asosab/bot_sigue_linea/web/assets/img/bola_trasera_construccion.jpg

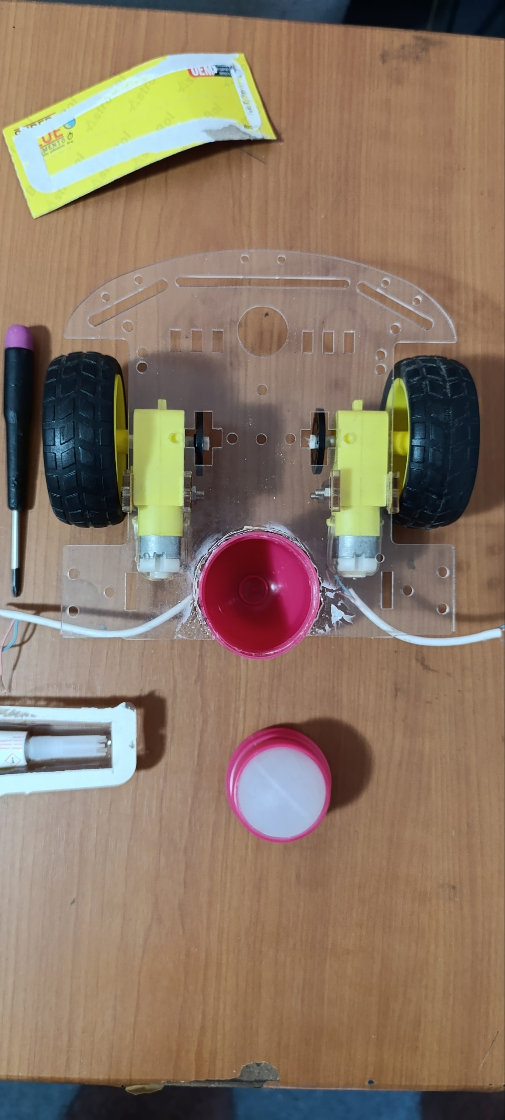
web/assets/img/bola_trasera_construccion.jpg
