asosab/bot_sigue_linea/web/assets/img/linea_de_prueba.jpg

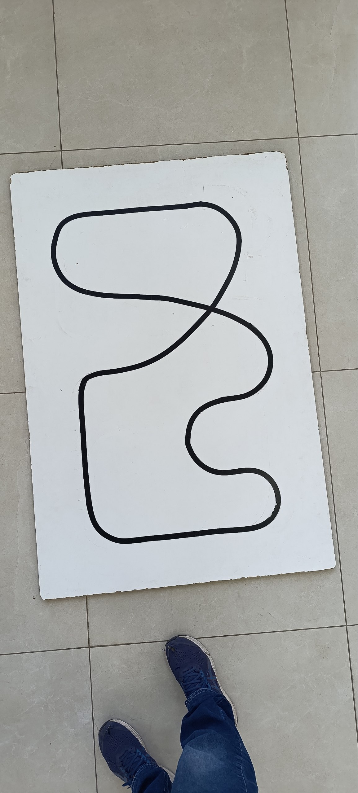
web/assets/img/linea_de_prueba.jpg
