asosab/bot_sigue_linea/web/assets/pdf/anexo-G-reconocimiento_concurso_robotica.pdf

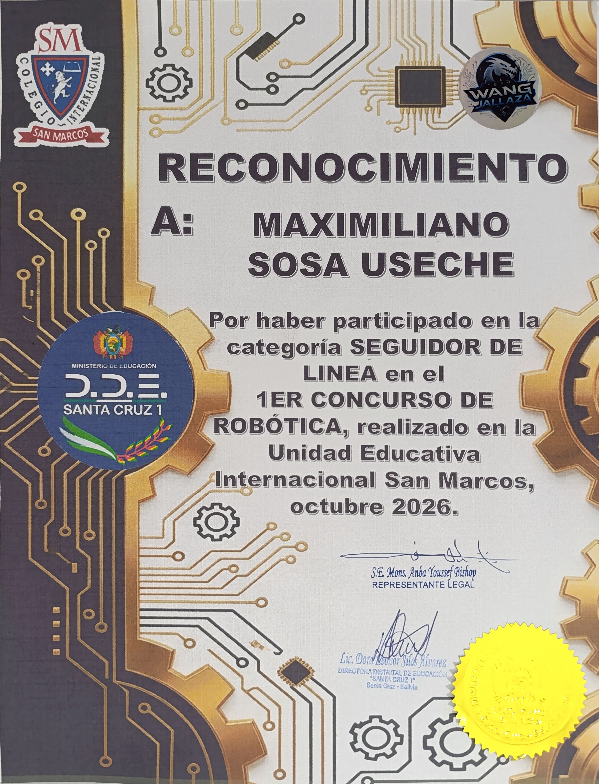
[picture p4: page 1]
