asosab/bot_sigue_linea/web/assets/img/afinando-sensores.jpg

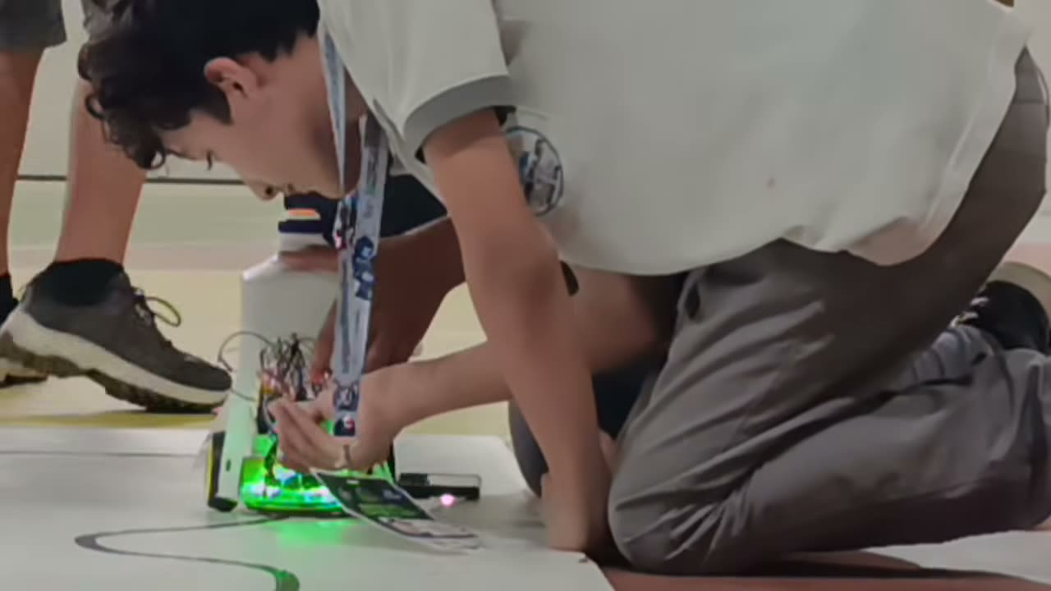
web/assets/img/afinando-sensores.jpg
