asosab/bot_sigue_linea/web/assets/img/anexo-D1-captura-borrado-y-expulsion.jpg

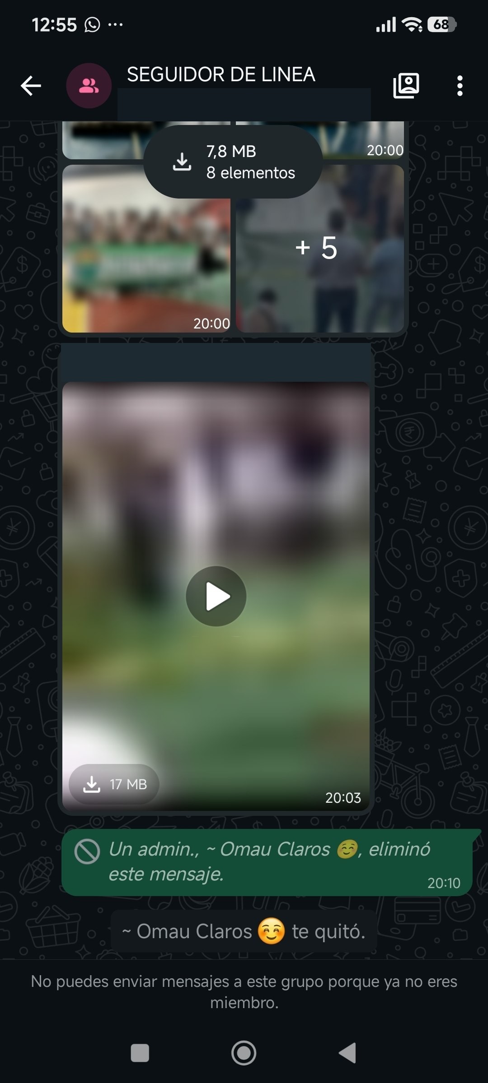
web/assets/img/anexo-D1-captura-borrado-y-expulsion.jpg
