asosab/bot_sigue_linea/web/assets/img/anexo-D2-captura-expulsiones-tercero.jpg

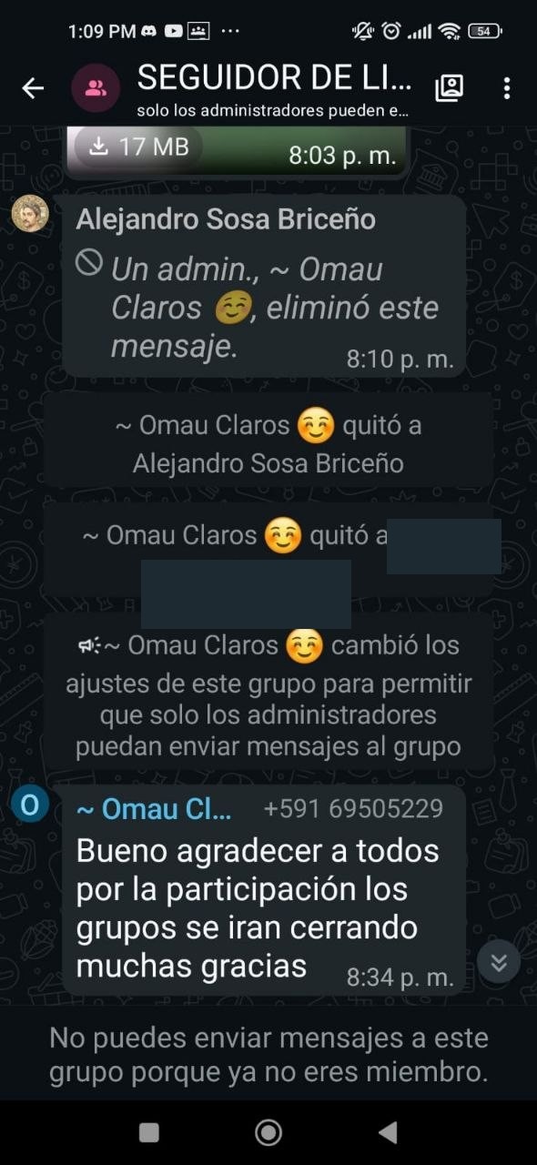
web/assets/img/anexo-D2-captura-expulsiones-tercero.jpg
