asosab/bot_sigue_linea/web/assets/img/anexo-F1-captura-publicacion-distrito.png

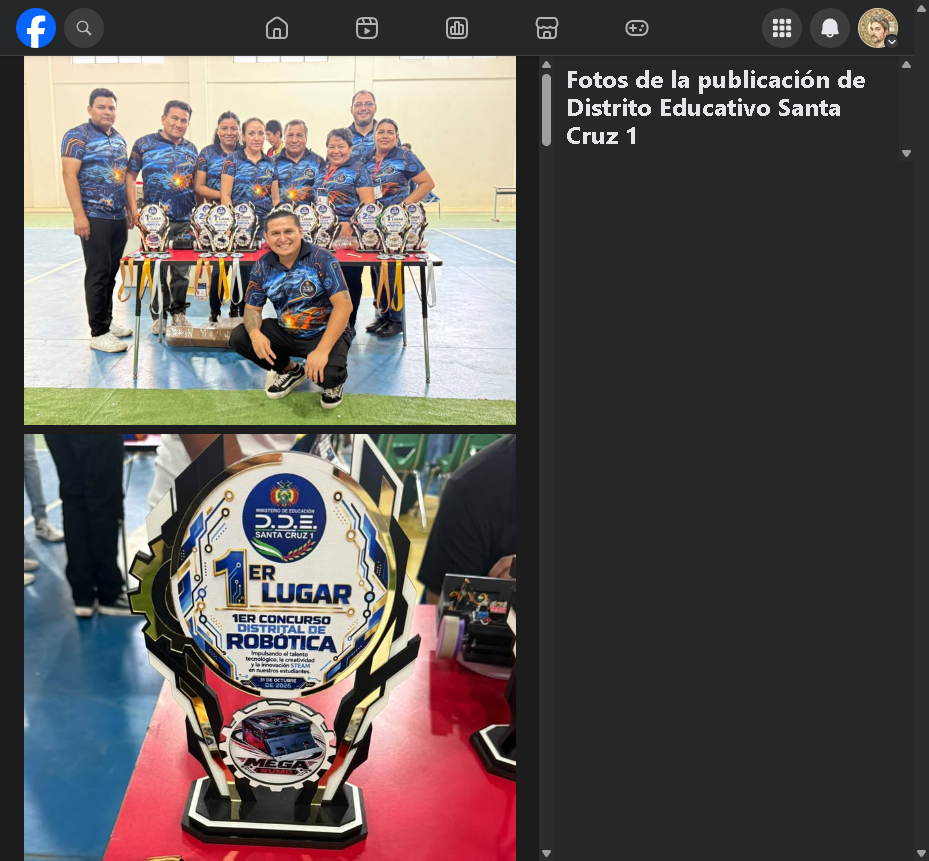
web/assets/img/anexo-F1-captura-publicacion-distrito.png
