asosab/bot_sigue_linea/web/assets/img/bola_trasera.jpg

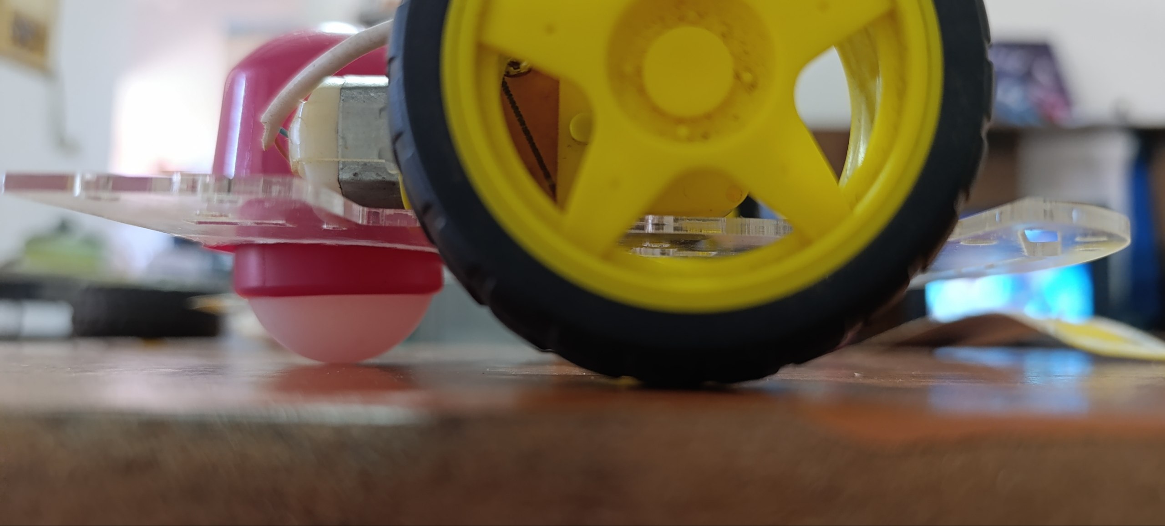
web/assets/img/bola_trasera.jpg
