asosab/bot_sigue_linea/web/assets/img/bot_cableando.jpg

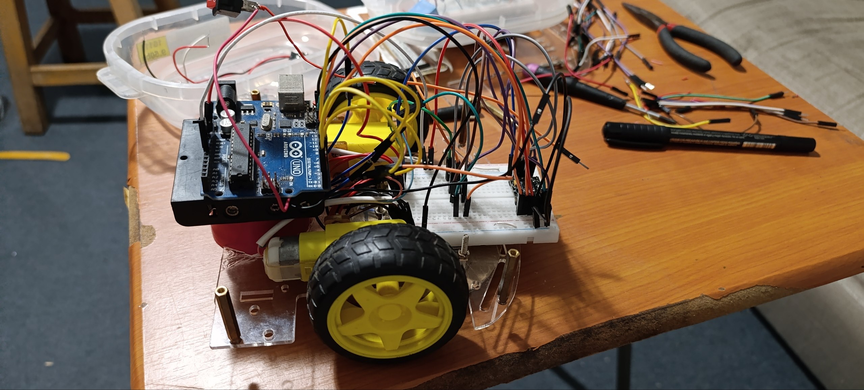
web/assets/img/bot_cableando.jpg
