asosab/bot_sigue_linea/web/assets/img/Christopher_Darius_Valero_Lima.jpg

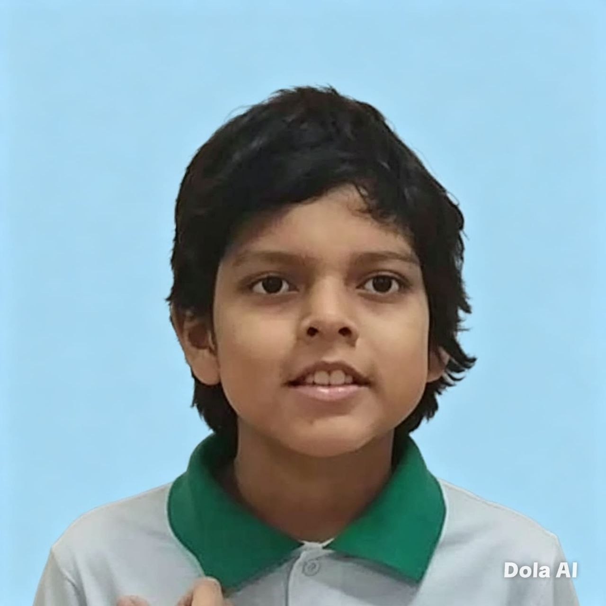
web/assets/img/Christopher_Darius_Valero_Lima.jpg
