asosab/bot_sigue_linea/web/assets/img/compartir.png

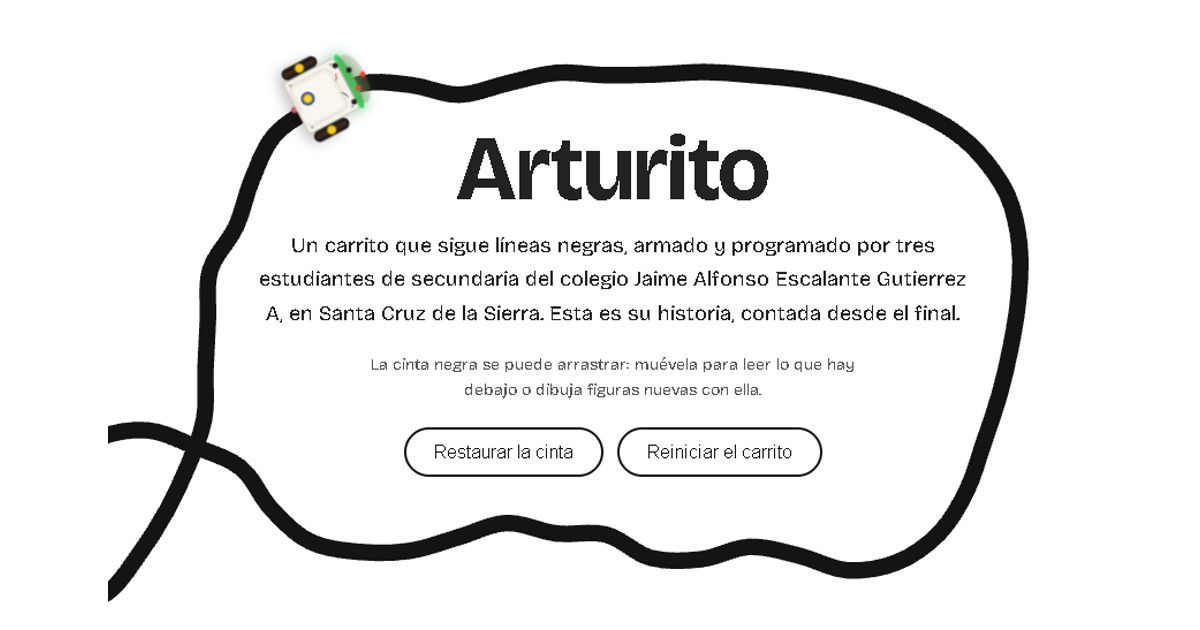
web/assets/img/compartir.png
