asosab/bot_sigue_linea/web/assets/img/formacion_sensores_luz.jpg

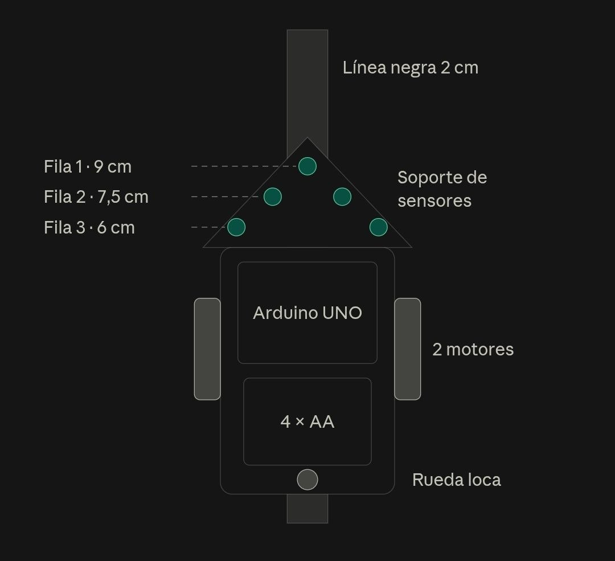
web/assets/img/formacion_sensores_luz.jpg
