asosab/bot_sigue_linea/web/assets/img/Gaby_Leryn_Ayala_Chambi.jpg

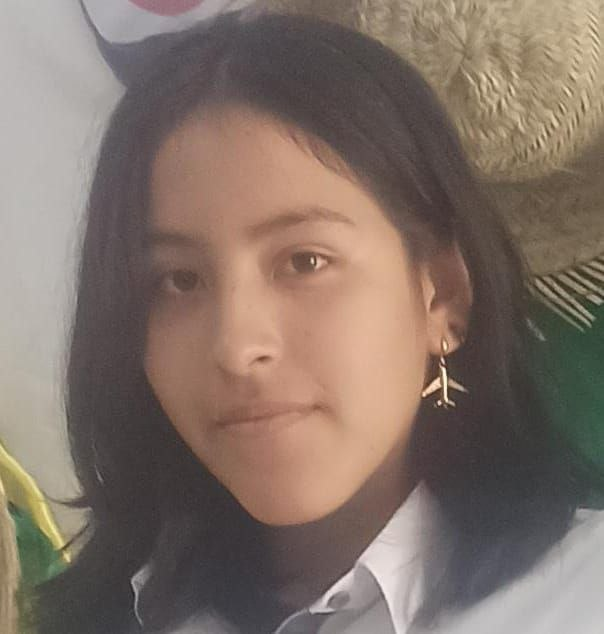
web/assets/img/Gaby_Leryn_Ayala_Chambi.jpg
