asosab/bot_sigue_linea/web/assets/img/gaby_y_max_concurso.jpg

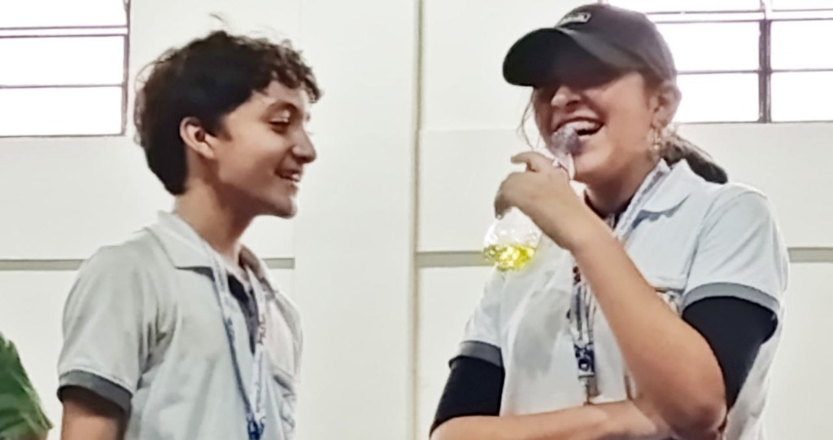
web/assets/img/gaby_y_max_concurso.jpg
