asosab/bot_sigue_linea/web/assets/img/Maximiliano_Sosa_Useche.jpg

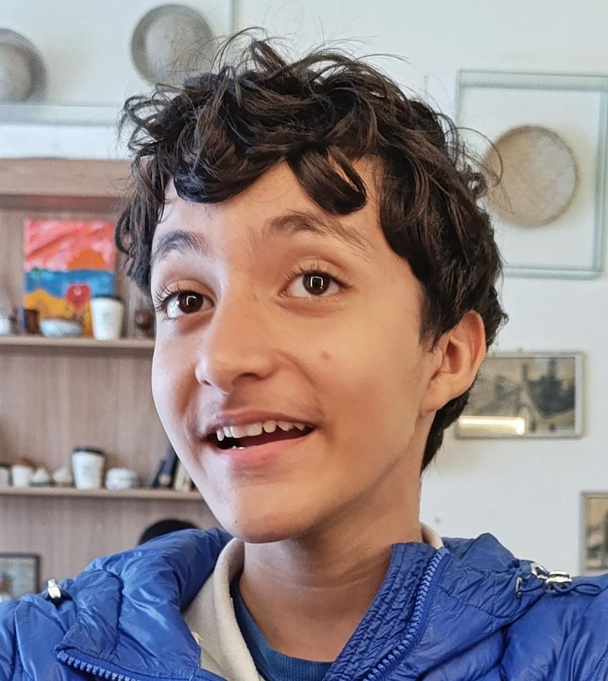
web/assets/img/Maximiliano_Sosa_Useche.jpg
