asosab/bot_sigue_linea/web/assets/img/sensores.jpg

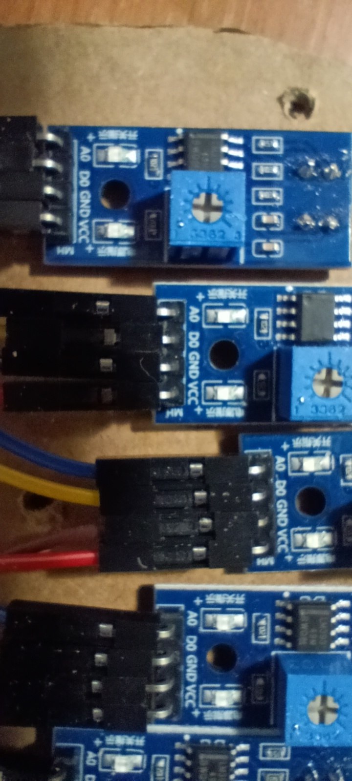
web/assets/img/sensores.jpg
