asosab/bot_sigue_linea/web/assets/img/sensores_instalados.jpg

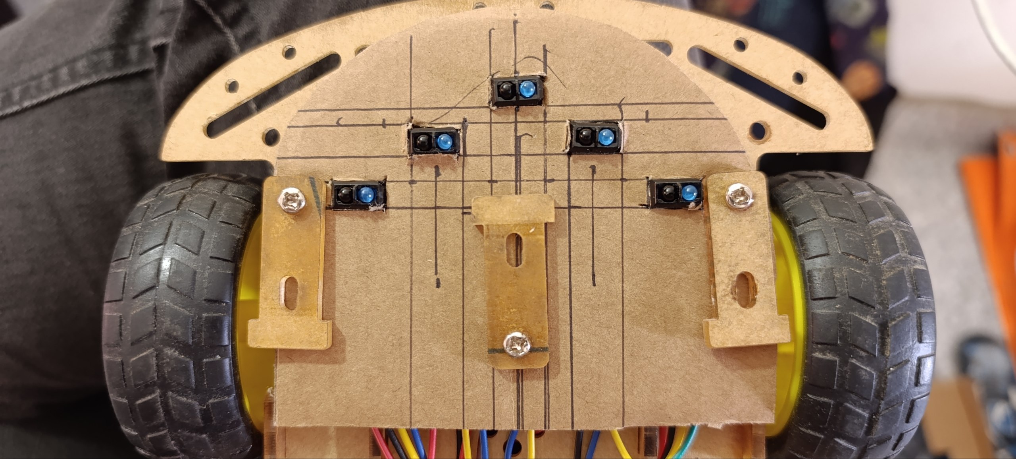
web/assets/img/sensores_instalados.jpg
