asosab/bot_sigue_linea/web/assets/img/yt-arturito-vuelta.jpg

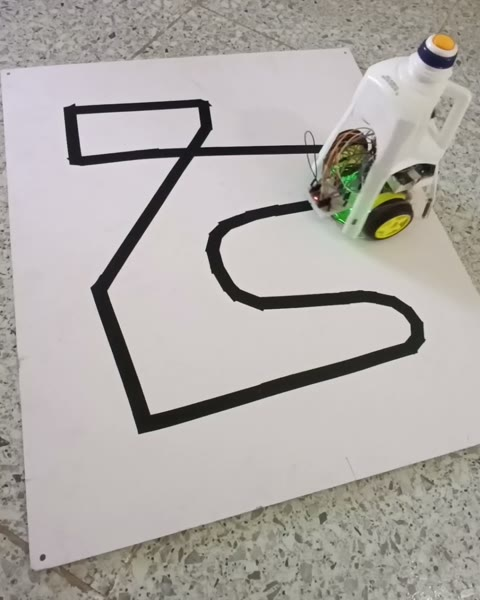
web/assets/img/yt-arturito-vuelta.jpg
