asosab/bot_sigue_linea/web/assets/img/yt-san-marcos-1.jpg

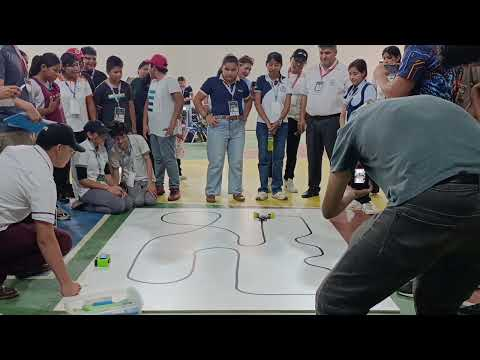
web/assets/img/yt-san-marcos-1.jpg
