asosab/bot_sigue_linea/web/assets/img/yt-san-marcos-2.jpg

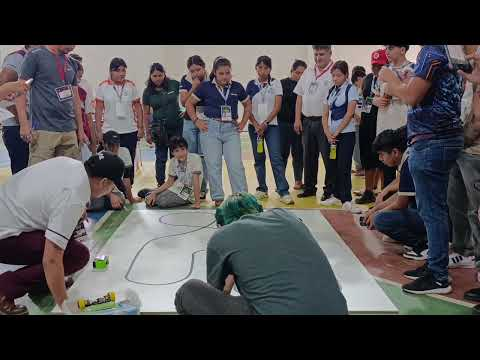
web/assets/img/yt-san-marcos-2.jpg
