asosab/bot_sigue_linea/web/assets/img/bot_linea_prueba.jpg

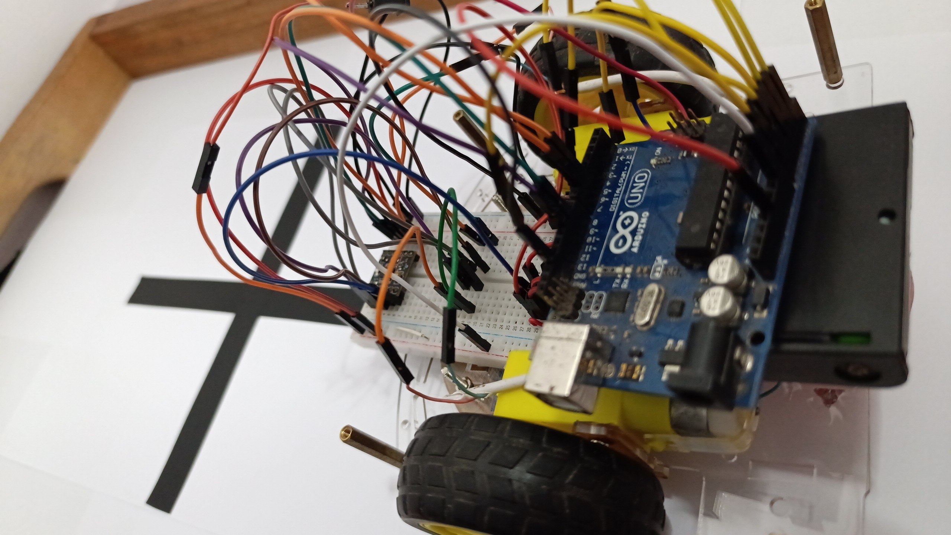
web/assets/img/bot_linea_prueba.jpg
