asosab/bot_sigue_linea/firmware/arturito_cv2_12/arturito_cv2_12.ino

/*
 * ==========================================================
 * ROBOT: ARTURITO CV2.12 - COMPETENCIA (v2.12 sin EEPROM)
 * CONCURSO: 1er Concurso Distrital de Robotica 2026 (Santa Cruz)
 * ==========================================================
 * Base: v2.11, intacta (la ultima verificada: 19.3 s, circuito
 * completo). La v2.12 agrega un solo cambio reversible:
 *
 *   v2.12  Recuperacion = la de v2.11, intacta. Se probaron dos
 *          fases (350 ms ultimoLado + 700 ms contrario) y acotar
 *          el pivoteo a 500 ms: el lazo seguia fallando, el
 *          problema no es COMO busca sino QUE no sabe hacia donde
 *          se fue la linea.
 *
 *          Diagnostico nuevo: cada evento 'P' guarda una mascara
 *          de los sensores que aun veian linea (negrura > 0.15)
 *          en el primer ciclo de la perdida. En la esquina del
 *          lazo dice si la linea se escapa por S3/S4 (el bot ya
 *          paso el vertice: problema de llegada) o por S0/S1.
 *          Se lee en el informe como "vista: Sx Sy".
 *
 *          Rebobinado recto: el diferencial viejo giraba la nariz
 *          al lado contrario del que se fue la linea (la rueda de
 *          ese lado retrocedia mas rapido) — origen real de los
 *          regresos de 180 grados. Ahora retrocede en linea con
 *          el rumbo congelado: lo que reenganche queda de frente.
 *
 *          Reenganche honesto en la busqueda: un roce en una punta
 *          ya no cuenta como linea encontrada — exige el trio
 *          S1/S2/S3 sobre la linea (TRIO_ENGANCHE). En la 2a
 *          esquina del lazo el pivoteo mordia la linea de entrada
 *          en angulo malo y salia para atras. Ademas el pivoteo
 *          se acota a 450 ms (~120-150 grados): si en el cono
 *          delantero no hay enganche solido, rebobina con el
 *          rumbo original.
 *
 *          Lado de busqueda por posF con umbral 0.2 (era 0.5): la
 *          mascara 'vista' mostro la linea escapando por S0 y el
 *          bot pivotando a la derecha — posF filtrado no llegaba
 *          a -0.5 antes de perderla y ultimoLado quedaba con un
 *          valor viejo. Con 0.2 una salida rapida ya marca lado.
 *
 *          Calibracion viva de largada: mientras espera el boton,
 *          el apoyo siembra la pista en cada ciclo — S0/S4 siempre
 *          ven blanco y S2 siempre negro, ese rango real
 *          reemplaza a la calibracion de laboratorio (idea
 *          rescatada del enfoque de v2.5/v2.6: cada comienzo
 *          define su propio blanco/negro). La compuerta pasa a
 *          medir margen en ADC crudo, no negrura normalizada.
 *
 *          Boost de recta: si |posF| < RECTA_POS se sostiene
 *          RECTA_CICLOS seguidos (~140 ms de linea centrada, no
 *          un instante entre curvas), VEL_MAX suma BOOST_RECTA
 *          (180 -> 205). Al moverse posF, vuelve a 180: las
 *          esquinas se siguen tomando a la velocidad conocida.
 *          Primera corrida (40 ciclos, pos 0.3): 20.2 s — el
 *          boost probablemente nunca se armo; ahora se afloja el
 *          requisito y cada activacion queda como evento 'B' en
 *          el informe, para ver si dispara y donde.
 *
 * Descartado en el camino (experimentos que rompieron la esquina
 * de 90 del lazo; no van):
 *   - Cruce por suma (SUMA_CRUCE): un vertice de esquina tambien
 *     pone varios sensores sobre linea a la vez; el avance recto
 *     comprometido se la pasaba de largo. La suma no distingue
 *     cruce de esquina.
 *   - LADO_MIN en la gracia y GIRO_BUSQUEDA_MS 500: parches al
 *     error que el cruce por suma introducia. Con la base de
 *     v2.11 la esquina se resolvia sola.
 *
 * Cambios heredados de v2.11:
 *
 *   v2.11  PERDIDA_CICLOS 1 -> 10 (gracia antes de recuperar: la
 *          corrida anterior registro 86 "perdidas" en 21.5 s, una
 *          cada ~0.25 s; son parpadeos de la suma de negrura bajo
 *          el umbral 0.3, no salidas de linea. Cada uno disparaba
 *          el pivoteo de busqueda y frenaba el avance. Ahora hay
 *          que perder ~60-70 ms seguidos para entrar a recuperar;
 *          durante la gracia sigue el PD con la ultima posF).
 * Cambios heredados de v2.1:
 *
 *   Ronda 1  KD 25 -> 80          (derivada con efecto real)
 *            TRIM_DER 1.0 -> 1.02 (compensa deriva a la derecha)
 *   Ronda 2  AVANCE_CRUCE_MS 200 -> 140 (menos avance ciego)
 *   Ronda 3  K_PUNTA 1.0 -> 0.5   (S0/S4 tiran menos cuando
 *                                  S1/S2/S3 ya ven la linea)
 *   Extra    Registro en EEPROM (sin cable en pista): tiempo,
 *            perdidas, cruces, linea de tiempo de eventos y
 *            calibracion final. Se lee despues por Serial:
 *            'r' muestra el informe, 'b' lo borra.
 *
 * Para volver a v2: KD=25, TRIM_DER=1.0, AVANCE_CRUCE_MS=200,
 * K_PUNTA=1.0, PERDIDA_CICLOS=1, BOOST_RECTA=0,
 * GIRO_BUSQUEDA_MS=1500, TRIO_ENGANCHE=0, SUMA_AMBIGUA=99.
 *
 * Arranque de competencia: se enciende en la mano, con motores
 * parados, se apoya sobre la linea. Apretar el pulsador de
 * largada (D8) prepara el arranque y soltarlo larga el robot,
 * siempre que S2 siga sobre negro y los extremos S0/S4 libres:
 * si esta mal apoyado no arranca y da tiempo de reacomodarlo.
 * Mantenerlo apretado mientras se baja el robot tambien sirve:
 * larga al soltar. En carrera, apretar detiene y devuelve a la
 * espera; un ciclo apretar-soltar nuevo lo relanza con la misma
 * regla. Sin prueba de motores ni ventana de calibracion: el
 * reglamento no permite tocarlo una vez en carrera. Antes de
 * pulsar se puede verificar el LED del modulo S2 encendido
 * = esta viendo la linea.
 *
 * - Posicion continua (media ponderada de los 5 canales
 *   analogicos) filtrada con EMA: corta el bamboleo.
 * - Velocidad adaptativa: a fondo en rectas, baja en curvas.
 * - Calibracion adaptativa: parte de valores de laboratorio y
 *   se ajusta sola en marcha; al apoyarlo, la posicion de
 *   salida siembra el blanco y el negro reales de la pista.
 * - Interseccion: al ver todo negro avanza recto un tramo
 *   fijo sin leer, para no tomar un ramal por una lectura a
 *   medio cruce.
 * - Recuperacion: gira hacia el ultimo lado que vio la linea
 *   y, si no la encuentra, rebobina (retrocede buscando).
 * - Trim de motores: TRIM_IZQ/TRIM_DER corrigen la deriva en
 *   recta (medir en el piso y ajustar a mano).
 *
 * Hardware: UNO + 5xTCRT5000 (A0..A4, flecha: S2 adelante,
 * S1/S3 medios, S0/S4 atras en las puntas) + DRV8833 (IN1..IN4
 * en D5/D6/D9/D10, EEP en D4, ULT en D2).
 */


// --- PINES ---
#define S0 A0 // extremo izquierdo (atras en la flecha)
#define S1 A1 // medio izquierdo
#define S2 A2 // centro (punta adelantada)
#define S3 A3 // medio derecho
#define S4 A4 // extremo derecho (atras en la flecha)

#define IN1 5   // motor izquierdo adelante (PWM)
#define IN2 6   // motor izquierdo atras (PWM)
#define IN3 9   // motor derecho adelante (PWM)
#define IN4 10  // motor derecho atras (PWM)
#define SLEEP_DRV 4 // EEP del DRV8833: HIGH = despierto
#define FAULT_PIN 2 // ULT del DRV8833 (opcional)
#define BTN 8       // pulsador de largada: entre D8 y GND, pull-up
                    // interno (presionado = LOW). Sin resistencias.

// --- PARAMETROS DE CONTROL ---
const int VEL_MAX = 180;   // velocidad en recta (190 perdio el camino)
const int VEL_MIN = 70;    // velocidad en curva cerrada
const float KP = 40.0;     // giro proporcional por unidad de posicion
const float KD = 80.0;     // amortigua el zigzag (v2: 25). Se mide por
                           // ciclo de loop: no cambiar delay(5) —
                           // delay(2) rompio el lazo (posF ruidosa)
const float KS = 70.0;     // cuanto baja la velocidad con el error
const float KS2 = 150.0;   // freno por derivada: posF moviendose rapido
                           // = curva empezando; baja antes de salirse
const float ALPHA = 0.4;   // filtro EMA de la posicion (0..1)
                           // (0.5 dejo posF nervioso: mas perdidas)
const int REV_MAX = 60;    // reversa maxima corrigiendo (anti-pivoteo)

// Trim de motores (1.0 = igual). Si tira a la derecha, bajar TRIM_IZQ
// o subir TRIM_DER. Se ajusta a mano tras la prueba de recta.
const float TRIM_IZQ = 1.0;
const float TRIM_DER = 1.02; // v2: 1.0

// Compuerta de arranque: margen en ADC crudo contra el blanco que
// ven S0/S4 en ese instante. Contrastes reales de pista ~800.
const int MARGEN_PISTA = 300;   // S2 tiene que superar al blanco en esto
                               // las puntas no pueden pasar de la mitad

// Puntas S0/S4: peso relativo cuando el trio S1/S2/S3 ya ve linea.
// 1.0 = como v2; 0.5 = mitad del tiron; 0.0 = puntas excluidas.
const float K_PUNTA = 0.5;
const float UMBRAL_TRIO = 0.3;

// Interseccion: avance recto comprometido al ver todo negro
const int VEL_CRUCE = 140;
const unsigned long AVANCE_CRUCE_MS = 140; // v2: 200

// Geometria ambigua: con esta suma hay mas de una linea bajo el
// arreglo (cruce o vertice de esquina); el centroide miente y
// posF se congela en lo que traia. 99 = desactivado.
const float SUMA_AMBIGUA = 2.0;

// Antirrebote del pulsador (flanco estable despues de este tiempo)
const unsigned long BTN_DEBOUNCE_MS = 50;

// Recuperacion de linea perdida
const unsigned long GIRO_BUSQUEDA_MS = 450; // arco de pivoteo antes de
                                            // rebobinar (v2.11: 1500 —
                                            // giraba ~180 y mordia la
                                            // linea en sentido contrario)
const float TRIO_ENGANCHE = 0.4; // durante la busqueda, el trio tiene que
                                // ver linea para aceptar el reenganche
                                // (0 = como v2.11: cualquier suma vale)
const int VEL_BUSQUEDA = 130;    // el barrido rapido (160) no funciono
const int VEL_REBOBINADO = 115; // 90 se quedaba clavado: sin fuerza
                                 // suficiente para mover el chasis

// Gracia de perdida: ciclos seguidos con suma <= umbral antes de
// entrar a recuperar. ~10 ciclos ~= 60-70 ms: filtra parpadeos.
// 1 = como v2.1 (entra al primer ciclo sin linea).
const int PERDIDA_CICLOS = 10;

// Boost de recta: |posF| bajo sostenido = recta de verdad; ahi
// VEL_MAX suma el boost. RECTA_POS 0 = recta perfecta exigida.
const float RECTA_POS = 0.35;   // |posF| maximo para contar recta
const int RECTA_CICLOS = 20;    // ~140 ms seguidos antes de subir
const int BOOST_RECTA = 25;     // extra sobre VEL_MAX (0 = apagado)

// Calibracion inicial de laboratorio (por canal; medir y rellenar).
// En cinta negra sobre papel blanco: blanco ~26-30, negro ~850-960.
int calMin[5] = {30, 30, 30, 30, 30};
int calMax[5] = {930, 930, 930, 930, 930};

// Posicion lateral de cada canal en la flecha: -2 izq .. +2 der
const float PESO[5] = {-2.0, -1.0, 0.0, 1.0, 2.0};
const int CANALES[5] = {S0, S1, S2, S3, S4};

int lecturas[5];
float posF = 0;
float posPrev = 0;
int ciclosPerdidos = 0;             // ciclos seguidos con suma baja
int ciclosRecta = 0;                // ciclos seguidos con |posF| bajo
byte maskPerdida = 0;               // sensores que veian linea al perderla
int ultimoLado = 0;                 // -1 izquierda, +1 derecha
unsigned long perdidaDesde = 0;
unsigned long cruceHasta = 0;
bool arrancado = false;
bool btnPrev = HIGH;                // pull-up: HIGH = suelto
bool preparado = false;             // pulsador apretado: armado para largar al soltar
unsigned long btnUltimo = 0;

// Medicion de pruebas: se guarda en EEPROM, se lee despues por Serial
unsigned int perdidas = 0;          // veces que entro en busqueda de linea
unsigned int cruces = 0;            // veces que detecto todo negro
unsigned long inicioCarrera = 0;

// Mapa de EEPROM (se conserva solo la ultima corrida)
const byte EE_FIRMA = 0xA2;         // marca de datos validos
const int EE_FIRMA_DIR = 0;         // 1 byte
const int EE_NEV = 1;               // 1 byte: cantidad de eventos
const int EE_TIEMPO = 2;            // 4 bytes: ms de carrera (0 = sin cierre)
const int EE_PERD = 6;              // 1 byte: perdidas
const int EE_CRUCES = 7;            // 1 byte: cruces
const int EE_CAL = 8;               // 20 bytes: calMin/calMax finales
const int EE_EVENTOS = 28;          // 4 bytes por evento:
                                    // tipo + decimas de s + mascara de vista
const int EE_MAX_EV = 120;

// --- MOTORES (velocidad con signo: + adelante, - atras) ---
void motorIzq(int vel) {
  vel = constrain(vel, -255, 255);
  if (vel >= 0) {
    analogWrite(IN1, vel);
    digitalWrite(IN2, LOW);
  } else {
    digitalWrite(IN1, LOW);
    analogWrite(IN2, -vel);
  }
}

void motorDer(int vel) {
  vel = constrain(vel, -255, 255);
  if (vel >= 0) {
    analogWrite(IN3, vel);
    digitalWrite(IN4, LOW);
  } else {
    digitalWrite(IN3, LOW);
    analogWrite(IN4, -vel);
  }
}

void detener() {
  motorIzq(0); motorDer(0);
}

// --- SENSORES Y CALIBRACION ADAPTATIVA ---
// Lee los 5 canales y expande calMin/calMax con cada extremo nuevo.
void leerSensores() {
  for (int i = 0; i < 5; i++) {
    int v = analogRead(CANALES[i]);
    lecturas[i] = v;
    if (v < calMin[i]) calMin[i] = v;
    if (v > calMax[i]) calMax[i] = v;
  }
}

// Negrura de un canal normalizada 0..1 segun su calibracion
float negrura(int i) {
  float n = (float)(lecturas[i] - calMin[i]) / (float)(calMax[i] - calMin[i]);
  if (n < 0) n = 0;
  if (n > 1) n = 1;
  return n;
}

// Calibracion viva: corre en cada ciclo de la espera. El apoyo
// garantiza S0/S4 sobre blanco y S2 sobre negro, asi que el blanco
// real es el menor de las puntas y el negro real lo da S2. Si no
// hay contraste (en la mano, mal apoyado) no siembra.
void sembrarPista() {
  int blanco = min(lecturas[0], lecturas[4]);
  int negro = lecturas[2];
  if (negro - blanco < 50) return;
  for (int i = 0; i < 5; i++) {
    calMin[i] = blanco;
    calMax[i] = negro;
  }
}

// EEPROM desactivada en competencia: stubs sin costo de escritura
void eeIniciar(){}
void eeEvento(char tipo, byte info){}
void eeCerrar(){}
void eeBorrar(){}
void eeInforme(){}

void setup() {
  pinMode(IN1, OUTPUT);
  pinMode(IN2, OUTPUT);
  pinMode(IN3, OUTPUT);
  pinMode(IN4, OUTPUT);
  detener();

  // Despertar el DRV8833 (EEP en HIGH)
  pinMode(SLEEP_DRV, OUTPUT);
  digitalWrite(SLEEP_DRV, HIGH);
  pinMode(FAULT_PIN, INPUT_PULLUP);
  pinMode(BTN, INPUT_PULLUP); // presionado = LOW

  Serial.begin(9600);
  Serial.println(F("===== ARTURITO CV2.12 ====="));
  Serial.println(F("Competencia: sin registro EEPROM"));
}

void loop() {
  leerSensores();

  // 1. Pulsador: flancos con antirrebote. Apretar prepara la
  //    largada, soltar la ejecuta; en carrera, apretar detiene.
  bool btn = digitalRead(BTN);
  bool flancoBajo = false, flancoAlto = false;
  if (btn != btnPrev && millis() - btnUltimo > BTN_DEBOUNCE_MS) {
    btnUltimo = millis();
    btnPrev = btn;
    if (btn == LOW) flancoBajo = true;
    else flancoAlto = true;
  }

  // 2. Compuerta de arranque: apretar arma y soltar larga, solo si
  //    el apoyo es bueno en ese instante. La prueba es en ADC crudo
  //    contra el blanco que ven S0/S4 ahora: S2 tiene que superarlo
  //    con margen y ninguna punta puede acercarse al negro.
  if (!arrancado) {
    if (flancoBajo) preparado = true;
    if (flancoAlto && preparado) {
      preparado = false;
      int blanco = min(lecturas[0], lecturas[4]);
      bool apoyoOk = lecturas[2] - blanco > MARGEN_PISTA &&
                     lecturas[0] - blanco < MARGEN_PISTA / 2 &&
                     lecturas[4] - blanco < MARGEN_PISTA / 2;
      if (apoyoOk) {
        arrancado = true;
        posF = posPrev = 0;
        perdidaDesde = 0;
        cruceHasta = 0;
        perdidas = 0;
        cruces = 0;
        eeIniciar();
        inicioCarrera = millis();
        Serial.print(F("Pista: blanco ")); Serial.print(blanco);
        Serial.print(F(" negro ")); Serial.println(lecturas[2]);
      }
    }
    if (!arrancado) {
      detener();
      sembrarPista(); // siembra en vivo mientras espera la largada
      if (Serial.available()) {
        char c = Serial.read();
        if (c == 'r') eeInforme();
        else if (c == 'b') eeBorrar();
      }
      delay(5);
      return;
    }
  }
  // 3. En carrera: apretar detiene y devuelve a la espera. El mismo
  //    apretado no arma (preparado queda en falso), asi que soltar
  //    no relanza.
  else if (flancoBajo) {
    arrancado = false;
    detener();
    eeCerrar();
    delay(5);
    return;
  }

  // 2. Cruce comprometido: recto sin leer hasta que venza el tramo
  if (cruceHasta) {
    if (millis() < cruceHasta) {
      motorIzq(VEL_CRUCE); motorDer(VEL_CRUCE);
      delay(5);
      return;
    }
    cruceHasta = 0;
  }

  // 3. Lectura ponderada. Si el trio S1/S2/S3 ya ve linea, las
  //    puntas S0/S4 votan con peso K_PUNTA (un brazo de la X bajo
  //    una punta tira menos del centroide).
  float suma = 0, sumaP = 0;
  bool todoNegro = true;
  float trio = negrura(1) + negrura(2) + negrura(3);
  float kPunta = (trio > UMBRAL_TRIO) ? K_PUNTA : 1.0;
  for (int i = 0; i < 5; i++) {
    float n = negrura(i);
    if (n < 0.7) todoNegro = false;
    if (i == 0 || i == 4) n *= kPunta;
    suma += n;
    sumaP += PESO[i] * n;
  }

  // 4. Cruce o bifurcacion: armar el avance recto temporizado.
  //    ultimoLado se conserva: si era una esquina cerrada y no un
  //    cruce, la recuperacion sigue buscando al lado correcto.
  if (todoNegro) {
    cruceHasta = millis() + AVANCE_CRUCE_MS;
    posF = posPrev = 0;
    perdidaDesde = 0;
    cruces++;
    motorIzq(VEL_CRUCE); motorDer(VEL_CRUCE);
    eeEvento('C', 0);
    delay(5);
    return;
  }

  // 5. Linea a la vista: PD sobre la posicion filtrada.
  //    En busqueda, un roce en una punta no vale: exigir el trio.
  bool enLinea = suma > 0.3 && (perdidaDesde == 0 || trio > TRIO_ENGANCHE);
  if (enLinea) {
    // Geometria ambigua (mas de una linea bajo el arreglo): no
    // confiar en el centroide. posF y ultimoLado se congelan en
    // lo que traian: en cruce sigue derecho, en vertice sigue
    // girando. La derivada queda en 0 porque posF no cambia.
    if (suma < SUMA_AMBIGUA) {
      float pos = sumaP / suma;            // -2 (izq) .. +2 (der)
      posF += ALPHA * (pos - posF);        // EMA: corta los saltos

      if (posF > 0.2) ultimoLado = 1;     // v2.11: 0.5 — posF filtrado
      else if (posF < -0.2) ultimoLado = -1; // no llegaba y buscaba al reves
    }
    float deriv = posF - posPrev;
    posPrev = posF;
    perdidaDesde = 0;
    ciclosPerdidos = 0;
    if (abs(posF) < RECTA_POS) ciclosRecta++;
    else ciclosRecta = 0;

    int velMax = VEL_MAX;
    if (ciclosRecta >= RECTA_CICLOS) {
      velMax += BOOST_RECTA;
      if (ciclosRecta == RECTA_CICLOS) eeEvento('B', 0); // marca el instante en que arma
    }
    int base = (int)(velMax - KS * abs(posF) - KS2 * abs(deriv));
    if (base < VEL_MIN) base = VEL_MIN;

    float corr = KP * posF + KD * deriv;
    int velIzq = constrain((int)((base + corr) * TRIM_IZQ), -REV_MAX, 255);
    int velDer = constrain((int)((base - corr) * TRIM_DER), -REV_MAX, 255);
    motorIzq(velIzq);
    motorDer(velDer);
    delay(5);
    return;
  }

  // 6. Linea perdida: primero gracia (seguir el PD con la ultima
  //    posF, sin derivada porque posF no cambia); solo si la baja
  //    se sostiene PERDIDA_CICLOS seguidos, recuperar de verdad.
  ciclosPerdidos++;
  if (ciclosPerdidos == 1) {
    // foto del instante en que la linea se fue: que sensores la
    // veian todavia (diagnostico del informe, "vista")
    maskPerdida = 0;
    for (int i = 0; i < 5; i++) {
      if (negrura(i) > 0.15) maskPerdida |= (1 << i);
    }
  }
  if (ciclosPerdidos < PERDIDA_CICLOS) {
    int base = (int)(VEL_MAX - KS * abs(posF));
    if (base < VEL_MIN) base = VEL_MIN;
    float corr = KP * posF;
    int velIzq = constrain((int)((base + corr) * TRIM_IZQ), -REV_MAX, 255);
    int velDer = constrain((int)((base - corr) * TRIM_DER), -REV_MAX, 255);
    motorIzq(velIzq);
    motorDer(velDer);
    delay(5);
    return;
  }

  bool nuevaPerdida = false;
  if (perdidaDesde == 0) {
    perdidaDesde = millis();
    perdidas++;
    nuevaPerdida = true;
  }
  unsigned long perdidaMs = millis() - perdidaDesde;

  if (perdidaMs < GIRO_BUSQUEDA_MS) {
    // Pivotar en el sitio hacia el ultimo lado conocido
    int giro = (ultimoLado >= 0) ? VEL_BUSQUEDA : -VEL_BUSQUEDA;
    motorIzq(giro);
    motorDer(-giro);
  } else {
    // Rebobinar recto: retroceder sobre el camino con el rumbo
    // congelado. El diferencial anterior giraba la nariz AL LADO
    // CONTRARIO del que se fue la linea (rueda de ese lado mas
    // rapida atras) y al reenganchar salia en sentido inverso.
    motorIzq(-VEL_REBOBINADO);
    motorDer(-VEL_REBOBINADO);
  }
  if (nuevaPerdida) eeEvento('P', maskPerdida);
  delay(5);
}
