asosab/bot_sigue_linea/firmware/arturito_v3_53/arturito_v3_53.ino

/*
 * ==========================================================
 * ROBOT: ARTURITO v3.53 - SEGUIDOR DE LINEA: S2 ANCLA + ALERTAS
 * DESARROLLO: linea de aprendizaje post-concurso
 * ==========================================================
 * Esquema de versiones 3.0x: cada decimal es una vuelta al
 * circuito para ajustar la respuesta. Objetivo de esta etapa:
 * S2 nunca deja de ver linea negra. No es un asunto de
 * velocidad — cuando se logre, se sube VEL_MAX en progresion
 * y se reajustan las respuestas.
 *
 * v3.53 (vuelta 53): la firma C (S0 && S4) se comio el vertice
 * derecho en reversa — un vertice tambien prende las dos puntas
 * con el trio muerto. Ahora C exige trio > TRIO_MIN: en un
 * cruce real la recta sigue bajo el centro.
 *
 * v3.52 (vuelta 52): la vuelta en reversa perdio el ultimo
 * cruce pero el log se lleno a los 8.6 s — 115 eventos no
 * alcanzaban para la pista entera. EE_MAX_EV 200: la vuelta
 * completa tiene que caber en el registro.
 *
 * v3.51 (vuelta 51): el segundo cruce abierto del lazo llego
 * como S0+S1 breve -> S0 sola — la pareja duro <40 ms y la
 * puerta de trio oscuro nunca conto (S1 seguia prendido). El
 * E perdio la carrera con la perdida: 2.4 s a ciegas. Ahora la
 * punta sola sostenida >=30 ms basta — no exige trio oscuro.
 *
 * v3.50 (vuelta 50): el disparador por saturacion con trio
 * gatillaba en curvas que el lazo resolvia — 9 E en 7 s. La
 * correccion es que ademas pos no este volviendo: si deriv va
 * hacia el centro el lazo trabaja y el pivote seria un robo.
 *
 * v3.49 (vuelta 49): el segundo cruce del bucle perdio — pos
 * quedo clavado en -1.0 por ~800 ms CON el trio viendo linea
 * bajo S1: el disparador por saturacion solo corria en el
 * camino oscuro. Ahora tambien corre con el trio a la vista:
 * |posF|>0.95 sostenido >=300 ms = el proporcional ya fallo,
 * contra-rotacion hacia el lado del signo.
 *
 * v3.48 (vuelta 48): la interna del pivote seguia sin girar —
 * el piso de -110 quedaba bajo el umbral de stall (~135). La
 * interna ahora es siempre VEL_ESQ_INT pleno: el decaimiento
 * solo suaviza la que adelanta, nunca la que retrocede. Una
 * rueda adelante y otra atras, como pide la maniobra.
 *
 * v3.47 (vuelta 47): el tercer giro a la izquierda llego solo
 * bajo S1 — sin punta sola ni pareja, el E no tenia firma.
 * pos saturado (|posF|>0.9 sostenido >=80 ms) es el vertice
 * llegando hacia el lado del signo: tercer disparador.
 *
 * v3.46 (vuelta 46): el lazo a la izquierda nunca contragiro —
 * la firma era S0+S1 juntos con el trio medio prendido, y las
 * puertas pedian trio totalmente oscuro. La pareja ahora se
 * mide por persistencia (>=40 ms juntos = vertice llegando;
 * un vaiven no sostiene una pareja tanto), no por oscuridad.
 *
 * v3.45 (vuelta 45): las U salian (3 resueltas) pero la mas
 * cerrada moria al final — el pivote se cortaba en 400 ms sin
 * completar el giro. ESQ_MAX 900. Y un pivote temprano se salto
 * el lazo: la pareja lateral con 1 ciclo oscuro gatillaba en
 * vaivenes — ahora exige 3 como la punta sola.
 *
 * v3.44 (vuelta 44): dos bugs en la esquina a la izquierda:
 * (a) la firma C de v3.39 (pareja lateral + S2) se comio el
 * vertice — una esquina real produce esa misma geometria. Lo
 * que parece cruce y es vertice va al camino de esquina, que
 * es recuperable; al reves mata la corrida. Firma eliminada.
 * (b) la interna con fuerza=0.5 quedaba en -70 (stall) y no
 * giraba — piso de -110: la rueda siempre rota sobre el eje.
 *
 * v3.43 (vuelta 43): detectaba la esquina pero doblaba tarde —
 * el "pivote" tenia la interna a -70, bajo el umbral de stall:
 * la rueda no giraba y el carro arqueaba adelante en vez de
 * rotar sobre su eje. Contra-rotacion simetrica -140/+140.
 *
 * v3.42 (vuelta 42): cruza tarde — el E dispara cuando la
 * firma (trio oscuro + punta sola) aparece, pero a 180 mm/s el
 * centro del chasis ya paso el vertice ~25 mm. La firma
 * temprana es la pareja lateral (S3+S4 o S0+S1) con el trio
 * debil: la barra llegando. El stop dispara ahi tambien.
 *
 * v3.41 (vuelta 41): el C se redeclaraba sobre la misma marca
 * cada ~140 ms — el carro quedo pegado en parada-arranque (23
 * cruces en 3.5 s). Enfriamiento de 800 ms como el de la esquina.
 *
 * v3.40 (vuelta 40): el "cruce" es una esquina de 90° — el
 * carro debe detenerse, girar sobre su eje y tomar la rama. La
 * firma S4 sola con trio oscuro era el vertice, pero las
 * puertas (80 ms de punta + 150 ms de trio oscuro) demoraban el
 * pivote ~250 ms: a 180 mm/s ya se pasaba del vertice. Punta
 * sola + 3 ciclos oscuros -> parada en seco + contra-rotacion
 * inmediata.
 *
 * v3.39 (vuelta 39): el cruce entrado descentralizado prende
 * S3+S4 (o S0+S1) sin que el trio se llene ni las puntas
 * coincidan — la masa lateral tira y el carro sigue la rama.
 * Tercera firma: pareja lateral + S2 = barra perpendicular con
 * el camino recto a la vista. En una curva real S2 se apaga.
 *
 * v3.38 (vuelta 38): el usuario recuerda el truco que
 * funcionaba — detenerse en seco sobre la marca del cruce para
 * no alejarse de ella. El C ahora frena 150 ms antes de
 * continuar derecho.
 *
 * v3.37 (vuelta 37): el cruce de 90° no declaraba C — exigia
 * S0&&S4 en el mismo ciclo y el travesano prendio el trio y unos
 * 100 ms despues la punta. Ventana de cruce: trio completo
 * prendido arma 400 ms; una punta sola dentro de ella es rama
 * del camino perpendicular — seguir derecho, no esquina.
 *
 * v3.36 (vuelta 36): bateria recien cargada — VEL_MAX 150->180,
 * mas potencia sobre el umbral y margen para que el arrastre no
 * limite las maniobras. La ley de "Riel" intacta.
 *
 * v3.35 (vuelta 35): el usuario lo vio — zigzag de tramos
 * rectos: dentro de la zona no corregia nada y a la salida un
 * ajuste grande. KP efectivo continuo 10->55 con la desviacion:
 * micro-cambios que sostienen una direccion realmente derecha.
 *
 * v3.34 (vuelta 34): no se movio — motores sonaban: la rampa
 * arranca en ~140 y tras el trim las ruedas reciben ~132, bajo
 * el umbral de stall medido. SUAVE_FRAC vuelve a 1.0: arranque a
 * 150 pleno. Si sigue sin moverse es la bateria.
 *
 * v3.33 (vuelta 33): el usuario lo apunta — en recta, ir
 * derecho apoyado en los datos de la linea. ZONA_RECTA 0.25:
 * con la linea bajo el centro, P+D en cero y solo queda el
 * auto-trim; cada jitter chico de pos disparaba un diferencial
 * que sembraba la siguiente desviacion. Tambien muy lento —
 * la base ya no cae por pos dentro de la zona.
 *
 * v3.32 (vuelta 32): objetivo recta sin que S2 caiga. En la
 * traza con bateria fresca el vaivén era el mismo y los 's'
 * caian con pos~0.1: S2 vive al borde. Pero el mecanismo del
 * barrido amplio para desvio chico es la integral: integ=-108
 * aportaba -32 PWM, mas que la P a pos 0.4 (22). INTEG_MAX 400
 * ->50: el auto-trim queda acotado a ~+-15 PWM.
 *
 * v3.31 (vuelta 31): dos palancas del usuario — el lazo corria
 * a ~100 Hz y en 10 ms el carro recorre 1.5 mm a ciegas; delay
 * 5->2 = ~200 Hz, el doble de decisiones por segundo. Y el
 * arranque vuelve a rampa: 0.93->1.0 en 2 s (arranca ~140, sobre
 * el umbral) acelerando mientras corrige la pose inicial.
 *
 * v3.30 (vuelta 30): sigue abanicando con arcos grandes que se
 * pasan de largo a S2 y alcanzan las puntas — el diferencial
 * base+70/35 ~4.5:1 es un arco demasiado cerrado. Techo a la
 * correccion: la rueda rapida no pasa de base+45 (diferencial
 * ~90 en vez de ~140), barrido mas lento y ancho.
 *
 * v3.29 (vuelta 29): precision de la regla — la reversa existe
 * solo en contra-rotacion (rueda contraria adelantando: gira en
 * el sitio, no retrocede) y solo en el caso extremo trio oscuro
 * + una punta. El arco hacia atras de 3.23 se descarta.
 *
 * v3.28 (vuelta 28): orden del usuario — cero reversa en todo.
 * La esquina vuelve al pivote frontal acotado (punta a 40 casi
 * clavada, exterior empuja 130) y la busqueda pivotea con una
 * rueda adelante sin rebobinado. La curva se resuelve barriendo
 * hacia adelante, que es lo que siempre funciono.
 *
 * v3.27 (vuelta 27): retrocedio encadenado en una esquina simple
 * (3 E seguidas — cada arqueo vencia sus 700 ms y se rearmaba al
 * expirar). Se autolimita: ESQ_MAX 300 (un vertice real remonta
 * en <300 ms; si no reengancha la linea no estaba atras) y 800 ms
 * de enfriamiento para que la busqueda normal recupere la curva
 * en vez de encadenar retrocesos.
 *
 * v3.26 (vuelta 26): retrocedio ante un cruce simple a la
 * derecha — la rama prende S4 con trio oscuro y el detonante lo
 * declara vertice. La esquina ahora exige ademas 150 ms de trio
 * oscuro: en un cruce la linea de adelante vuelve al trio y la
 * maniobra se aborta antes de armarse.
 *
 * v3.25 (vuelta 25): v3.24 pivoto 4 veces en 2.7 s sin esquinas
 * — el detonante confundia flaps del vaiven (trio parpadea, punta
 * roza) con vertices. Ahora la punta debe persistir 80 ms para
 * declarar esquina; mientras dura el dwell queda la gracia.
 *
 * v3.24 (vuelta 24): el pivote tambien se autorregula — la
 * fuerza del arqueado decae a la mitad cuando un medio del trio
 * ya ve la linea entrando, para no sobregirar el vertice.
 *
 * v3.23 (vuelta 23): la salida de pista del tramo final fue
 * una maniobra E sobre S0 — el pivote viejo (int -70, ext 140)
 * barria el arreglo en arco hacia adelante alejandolo de la
 * linea. Se invierte: la punta avanza 40 y la exterior retrocede
 * -90 — el carro se arquea hacia atras sobre el vertice.
 * Nota del registro: integ llego a -32 (~-10 PWM), el auto-trim
 * ya trabaja; P/t 0.48 fue el mejor del ciclo.
 *
 * v3.22 (vuelta 22): la integral ya acumula (integ 4->8) pero
 * su aporte es 0.15*8 = 1.2 PWM — anemico. Compuerta 0.7->1.0
 * (acumula en mas de la excursion) y KI 0.15->0.3 para que el
 * auto-trim pese en la correccion. Tope 400 igual.
 *
 * v3.21 (vuelta 21): la telemetria 'i' mostro que la integral
 * nunca trabajaba — el decaimiento anti-windup la evaporaba en
 * ~100 ms porque el carrito vive en excursion (integ quedo en
 * 0->8). Se cambia a congelar: solo acumula con |posF|<0.7 y en
 * excursion retiene el valor. Ademas: v3.20 fue la primera
 * corrida con 0 perdidas — el trio nunca quedo a oscuras; las
 * 's' restantes son S2 montando el borde, no escapes.
 *
 * v3.20 (vuelta 20): telemetria de la integral — evento 'i'
 * cada ~1 s con integ, para ver si el auto-trim converge (integ
 * estabilizandose) o no esta actuando. v3.19 dio la mejor P/t
 * del ciclo (0.58) con 5 resueltas desde +-1.5, pero s/t sigue
 * en ~1 — el carrito sobrevive mejor pero vive en el borde.
 *
 * v3.19 (vuelta 19): autoregulacion — pregunta del usuario. La
 * respuesta es el termino integral: posF descansando en +0.25 en
 * vez de 0 es el sesgo medido por el propio carrito; acumulandolo
 * y sumandolo a corr, el equilibrio vuelve a 0 sin tocar trim.
 * KI 0.15, integ topa en 400 y decae con |posF|>0.9 (anti-windup:
 * solo acumula en seguimiento, no en excursiones). v3.18 ademas
 * dio la mejor marca: 3 caidas de S2 (s/t 0.47) y el primer tramo
 * de 1.6 s con posF quieto ~0.25.
 *
 * v3.18: 135 no mueve el chasis ni con pilas nuevas — el umbral
 * de arranque queda entre 135 y 150 con la carga actual.
 * VEL_MAX vuelve a 150; queda GAN_BORDE 0.3 como unico ajuste
 * respecto a v3.15.
 *
 * v3.17 (vuelta 17): v3.16 no mejoro (s/t 1.29) — la amplifica-
 * cion vio la deriva temprano pero infla la escala (posF llego a
 * 2.21) y la banda media corre mas caliente. Con pilas nuevas el
 * umbral de arranque bajo y aparece la palanca que estaba
 * bloqueada: velocidad. VEL_MAX 150->135 y GAN_BORDE 0.6->0.3 —
 * excursiones mas lentas y chicas, deteccion temprana suave.
 *
 * v3.16 (vuelta 16): con pilas nuevas v3.15 corrio 6.0 s con 5
 * resueltas desde pos +-1.2 — pero la oscilacion sigue siendo de
 * amplitud ~+-1, el ancho del trio: para que S2 no caiga hay que
 * quedar bajo ~0.6. Ninguna ganancia baja la amplitud porque la
 * zona ciega (linea 20 mm, S1/S3 a +-15 mm) deja derivar +-5 mm
 * libre. pos se amplifica por el deficit de n2: el control ve la
 * deriva a los 2-3 mm en vez de a los 8.
 *
 * v3.15 (vuelta 15): con v3.14 el carrito no se movio en la
 * pista y la EEPROM quedo con la corrida anterior — nada se
 * registro. Aislamiento: SUAVE_FRAC=1.0 desactiva la rampa
 * (velMax 150 desde el primer ms). Si se mueve, el arranque en
 * ~127 quedo bajo el umbral actual del chasis; si no, es
 * potencia (bateria / cable al driver).
 *
 * v3.14 (vuelta 14): el usuario lo vio — arranca sobre la linea
 * y la pierde casi de inmediato en abanicos amplios. La traza lo
 * confirma: s/P en los primeros 200-300 ms de todas las corridas.
 * No es el regimen estacionario, es el transitorio de largada:
 * arranca a 150 de golpe y el primer desvio ya llega con todo el
 * momentum. Arranque suave: velMax rampa de 85% a 100% en 700 ms.
 *
 * v3.13 (vuelta 13): la proyeccion estadistica puso KS2 como la
 * palanca que actua antes de la saturacion — frena la excursion
 * mientras posF crece en zona lineal. v3.12: s/t 0.62 (mejor
 * desde 3.06), P/t 0.92, pero posF sigue llegando a +-0.9.
 * KS2 100->150 (el valor probado de la 2.x). Un solo cambio.
 *
 * v3.12 (vuelta 12): mejor corrida del ciclo — 7.0 s vivo, 2
 * resueltas desde pico 1.33 y 0.92, 5 caidas de S2. La ley PD +
 * piso de la interna sostiene; el patron ahora es deriva lenta a
 * pos profundo (~0.9) que se resuelve en el borde del arreglo.
 * KP 40->55: el diferencial ~36 a pos 0.9 no frenaba la deriva
 * antes del limite. Un solo cambio, medimos.
 *
 * v3.11: micro-ajustes, regla del usuario. Detener una rueda es
 * un macro-ajuste que puede pasarse si solo hay que mover
 * milimetros: en el seguimiento la rueda que frena tiene piso
 * hacia adelante (VEL_PISO_INT 35) — nunca se clava ni va a
 * reversa. La reversa solo vive en los pivotes de esquina y
 * busqueda, que son para cuando la linea ya se fue.
 *
 * v3.10 (vuelta 10): 9 vueltas lo confirmaron — el modelo de
 * "acelerar una rueda" mantenia ~140 mm/s de arrastre corrigiendo,
 * y con cinta de 20 mm cualquier giro suficiente la cruzaba por
 * inercia (v3.09 cuadratica: 17 P en 5.6 s). Se vuelve a la ley
 * probada de v2.11: PD simetrico base+-corr (KP 40, KD 80) con
 * base que cae por KS*|posF| + KS2*|deriv| — el carrito entero se
 * frena fuera de linea, no solo una rueda. La maquina 3.x queda
 * intacta (S2 ancla, esquina por puntas, cruce, telemetria 'm').
 *
 * v3.09 (vuelta 9): v3.08 dejo de cazar pero posF subia despacio
 * a +0.9 y no volvia — un solo valor de K no sirve: 90 bastaba
 * cerca del centro pero no en saturacion. Ganancia por banda:
 * corr = K_CORR*exceso + K_CORR2*exceso^2. Suave cerca del
 * centro (~14 PWM a pos 0.3), fuerte en saturacion (~135+ a
 * pos 0.9). Caia de S2: solo 2 en v3.08.
 *
 * v3.08 (vuelta 8): la muestra 'm' de v3.07 mostro posF clavada
 * +-0.9 por 400 ms de cada lado — no es jitter, es caza riel a
 * riel. La cuenta: corr 180*(pos-0.15) da diferencial ~245 a
 * pos=1, casi 3x lo que la v2.11 usaba para seguir a 19.3 s
 * (40*pos+80*deriv repartido +-: ~80-160). pos ademas se satura
 * en +-1 (linea bajo un solo sensor = sin gradiente fino) y la
 * correccion sobreactua justo ahi. K_CORR 180->90, resto igual.
 *
 * v3.07 (vuelta 7): la muestra 'm' mostro la forma del ciclo —
 * posF oscila +-0.8-1.1 cruzando el centro cada ~400 ms. No es
 * ruido ni falta de KD: es momentum. Corrigiendo a ~140 mm/s el
 * carrito cruza la cinta de 20 mm antes de que posF baje, y la
 * rueda interna en reversa lo convierte en giro en el sitio.
 * KS 50->80 (la base cae mas con el exceso) y piso de la interna
 * en 0 en el seguimiento — la reversa queda para los pivotes.
 * Dato bueno: caidas de S2 bajaron de 7-11 a 1.
 *
 * v3.06 (vuelta 6): KD 60->80 (el valor probado de la 2.x; 60 no
 * mato el ciclo en v3.05: 5 P en 3.7 s, 11 alertas con 2
 * resueltas). Y se agrega telemetria de muestreo: evento 'm'
 * cada 200 ms con posF — la forma de la oscilacion (amplitud,
 * frecuencia, si se amortigua o crece) dice si falta autoridad,
 * sobra ganancia o hay ruido, en vez de ajustar a tientas.
 *
 * v3.05 (vuelta 5): la corrida de v3.04 mostro el ciclo limite —
 * P->R cada 0.2-0.4 s, alertas de lado y lado: la correccion pura
 * proporcional no frena al retorno y el carrito cruza la linea de
 * lado a lado (los 'o' quedan en 0 porque el cruce pasa por tramos
 * oscuros y la alerta se cierra antes). Se agrega amortiguacion
 * por derivada: corrF = K_CORR*exceso*signo + KD*deriv, con el
 * mismo reparto acelera-externa/frena-interna aplicado a |corrF|.
 *
 * v3.04 (vuelta 4): la corrida de v3.03 perdio el camino de verdad —
 * el usuario lo vio: se mueve demasiado lateralmente buscando la
 * linea y se la pasa de largo. El pivote de busqueda a 130 gira
 * rapido y el reenganche a 0.45 la exige solida: cuando el trio la
 * acepta ya esta del otro lado. VEL_BUSQUEDA 130->110,
 * VEL_ESQ_EXT 170->140, TRIO_ENGANCHE 0.45->0.35. Riesgo anotado:
 * si 110 no gira el chasis, subir a 115.
 *
 * v3.03 (vuelta 3): la corrida de v3.02 ya se movio (6 perdidas
 * en 2.9 s, reenganches de 0.0-0.4 s, una alerta de posF 1.03
 * resuelta al centro) pero siguio sin haber sobrepasos: hay
 * margen para corregir mas. posF llegaba tarde — ALPHA 0.4->0.55
 * (posF sigue mas rapido a la linea real) y K_CORR 140->180
 * (autoridad en banda media, donde hoy escala a oscuras). Si
 * aparecen 'o', ese es el techo.
 *
 * v3.02 (vuelta 2): la corrida de v3.01 registro 2.2 s con todo
 * en cero — el carrito nunca se movio. VEL_MAX 120 quedo por
 * debajo del umbral de arranque del chasis con la bateria actual
 * (los motores sonaban sin avanzar). Se sube a 150, punto medio
 * reducido que seguro mueve; maniobras acordes. Ademas 'B' ya no
 * se registra cuando el boost esta apagado.
 *
 * v3.01 (vuelta 1): la corrida de v3.0 dio 42 perdidas y 0
 * sobrepasos — la correccion llega tarde y sin autoridad, no
 * se pasa. Ajustes: velocidad reducida (VEL_MAX 180 -> 120,
 * boost apagado), la rueda interna tambien frena en
 * proporcion (FRAC_INT: mismo giro, mas autoridad), la base
 * cae con la profundidad de la alerta (KS, como en la linea
 * 2.x) y la banda muerta se achica (0.25 -> 0.15) para
 * corregir antes. Fix del informe: 'R oscuros' guardaba
 * centesimas y las imprimia como segundos.
 *
 * Apertura de la linea 3.x sobre la base probada de v2.13
 * (19.3 s quedo como referencia de lo que dio el concurso; aca
 * el objetivo es entender y mejorar, no competir). Nada de la
 * v3 vieja (arturito_v3,
 * abandonada): las maniobras comprometidas a prueba y error
 * quedan descartadas. Modelo nuevo, una sola idea:
 *
 *   S2 nunca deberia soltar la linea.
 *
 *   S1/S3 son las alarmas tempranas: si uno se apaga, la linea
 *   se esta yendo a ese lado y toca corregir antes de que S2
 *   la pierda. S0/S4 son informacion de borde: prendidos los
 *   dos = cruce de caminos; uno solo con el trio oscuro = el
 *   vertice de una esquina que ya se paso, y la punta que ve
 *   linea dice a que lado doblar. Trio oscuro sin punta =
 *   perdida real; entra la recuperacion con la memoria del
 *   ultimo lado que vio linea.
 *
 * Correccion proporcional, no conmutada: fuera de una banda
 * muerta chica se acelera SOLO la rueda del lado que perdio la
 * linea, en proporcion a posF (media ponderada filtrada, misma
 * escala +-2 de la linea 2.x). Si la correccion pasa el techo
 * PWM, el exceso frena la rueda contraria — asi la alerta
 * profunda (solo S1 o solo S3 viendo) dobla fuerte sin cambiar
 * de modo.
 *
 * Telemetria (lo nuevo de la 3.0): cada alerta deja su evento
 * en EEPROM con el |posF| de entrada; al cerrarse queda
 * registrado si volvio limpio al centro ('k'), si se paso al
 * lado contrario ('o' = sobrepaso, correccion excesiva) o si
 * escalo a esquina/perdida. Cada caida de S2 deja evento 's'
 * con la mascara de quien seguia viendo linea. El ciclo de
 * ajuste es: correr -> 'r'/'t' por serial -> si mandan los 'o',
 * bajar K_CORR o subir MUERTA_POS; si mandan los 's', subir
 * K_CORR o bajar VEL_MAX. Meta: sobrepasos y caidas de S2 en
 * casi cero.
 *
 * Largada igual que la linea 2.x: apoyar sobre la linea, S2
 * sobre negro con S0/S4 libres. Apretar D8 prepara el arranque
 * y soltarlo larga; apretar en carrera detiene y devuelve a la
 * espera. La calibracion viva siembra la pista en la espera
 * (S0/S4 dan el blanco, S2 el negro).
 *
 * Hardware: UNO + 5xTCRT5000 (A0..A4, flecha: S2 adelante,
 * S1/S3 medios, S0/S4 atras en las puntas) + DRV8833 (IN1..IN4
 * en D5/D6/D9/D10, EEP en D4, ULT en D2).
 */

#include <EEPROM.h>

// --- PINES ---
#define S0 A0 // extremo izquierdo (atras en la flecha)
#define S1 A1 // medio izquierdo
#define S2 A2 // centro (punta adelantada)
#define S3 A3 // medio derecho
#define S4 A4 // extremo derecho (atras en la flecha)

#define IN1 5   // motor izquierdo adelante (PWM)
#define IN2 6   // motor izquierdo atras (PWM)
#define IN3 9   // motor derecho adelante (PWM)
#define IN4 10  // motor derecho atras (PWM)
#define SLEEP_DRV 4 // EEP del DRV8833: HIGH = despierto
#define FAULT_PIN 2 // ULT del DRV8833 (opcional)
#define BTN 8       // pulsador de largada: entre D8 y GND, pull-up
                    // interno (presionado = LOW). Sin resistencias.

// --- PARAMETROS DE CONTROL ---
const int VEL_MAX = 180;      // velocidad en recta. 3.02: 120 no
                              // movia el chasis (umbral de arranque);
                              // 150 es el piso que lo mueve con margen
const int VEL_MIN = 60;       // piso de la base bajo alerta profunda
// Ley de correccion = la probada de v2.11 (19.3 s): PD simetrico
// base+-corr y base que cae con |posF| y |deriv|. El modelo de
// "acelerar una rueda" de la 3.0x mantenia ~140 mm/s de arrastre
// corrigiendo: con cinta de 20 mm cualquier giro suficiente la
// cruzaba por inercia (9 vueltas lo confirmaron).
const float KP = 55.0;        // giro proporcional por unidad de posF
const float KP_ZONA = 10.0;   // KP dentro de la zona: un desvio de 0.1 da
                              // ~1 PWM — micro-ajuste, no barrido
const float KI = 0.3;        // integral: el sesgo sostenido de posF
                              // (equilibrio en +0.25, no en 0) acumula
                              // correccion hasta cancelarlo — el carrito
                              // calibra su propio centro sin tocar trim
const int INTEG_MAX = 50;     // tope de la integral: ~+-15 PWM a KI 0.3.
                              // integ llego a -108 = -32 PWM, mas que el
                              // termino P a pos chico — el barrido amplio
                              // para desvio chico lo inflaba la integral
const float ZONA_RECTA = 0.25; // zona de ganancia suave: el KP crece de
                              // KP_ZONA (micro-correccion continua, ruedas
                              // casi iguales) a KP pleno — corrige apenas
                              // se corre, no cuando ya se fue
                              // nada que corregir: P+D en cero y solo el
                              // auto-trim endereza — cada jitter chico
                              // disparaba un diferencial que sembraba
                              // la siguiente desviacion
                              // integ llego a -108 = -32 PWM, mas que el
                              // termino P a pos chico — el barrido amplio
                              // para desvio chico lo inflaba la integral
const float CORR_MAX = 45;    // techo de correccion: la rueda rapida
                              // no pasa de base+45 — el barrido es mas
                              // lento y ancho, no se pasa de largo a S2
                              // ni alcanza las puntas del triangulo
const float KD = 80.0;        // amortigua el retorno (valor v2 probado)
const float KS = 70.0;        // cuanto baja la base con |posF| (v2: 70)
const float KS2 = 150.0;      // freno por derivada: posF moviendose
                              // rapido = curva empezando; baja antes
                              // de salirse (v2: 150; 100 con la 3.x)
const unsigned long SUAVE_MS = 2000; // rampa de arranque: sube despacio mientras corrige
const float SUAVE_FRAC = 1.0;      // 0.93 arrancaba ~132 tras trim: bajo el umbral de stall
                                    // (~128, sobre el umbral de
                                    // arranque; 120 no movia)
const float GAN_BORDE = 0.3;  // amplifica pos por el deficit de n2:
                              // la deriva se ve cuando son 2-3 mm,
                              // no 8 — ataca la zona ciega
const float ALPHA = 0.4;      // filtro EMA (v2 probado; 0.5 la dejo
                              // nerviosa en las corridas de la 2.x)
const int REV_MAX = 60;       // reversa maxima en la rueda interna
const int VEL_PISO_INT = 35;  // piso hacia adelante de la rueda que
                              // frena en el seguimiento: micro-ajustes
                              // por diferencia de velocidad, nunca
                              // clavarla — detener una rueda es un
                              // macro-ajuste que barre la cinta.
                              // La reversa solo vive en los pivotes
                              // de esquina y busqueda.
const float K_PUNTA = 0.5;    // peso de S0/S4 dentro de pos (tiran
                              // menos: avisan, no mandan)
const float TRIO_MIN = 0.3;   // suma S1+S2+S3 para "trio ve linea"
const float TRIO_ENGANCHE = 0.35; // para volver de esquina/busqueda el
                              // trio tiene que verla. 3.04: 0.45 era
                              // tarde — al exigirla solida el pivote
                              // ya se la habia pasado de largo
const float SUMA_AMBIGUA = 2.0;   // suma con mas de una linea bajo el
                              // arreglo: posF se congela en lo que traia

// Umbrales binarios con histeresis: el sensor prende arriba de
// NEG_ON y apaga abajo de NEG_OFF; entre los dos conserva estado.
const float NEG_ON = 0.55;
const float NEG_OFF = 0.35;

// Alertas (solo telemetria: marcan donde medir el sobrepaso)
const float ALERTA_POS = 0.4; // |posF| donde arranca una alerta
const float ALERTA_OK = 0.2;  // |posF| donde la alerta se da por cerrada

// Muestreo periodico de posF para la traza (evento 'm'): la forma
// de la oscilacion dice si es ciclo limite, ruido o falta de
// autoridad — sin ella el ajuste va a tientas
const unsigned long MUESTRA_MS = 200;

// Esquina: trio oscuro con una sola punta viendo linea. El
// vertice ya quedo DETRAS del arreglo (por eso solo la punta
// trasera la ve): pivotar hacia adelante barre el arreglo en
// arco alejandolo de la cinta. Regla del usuario (3.23): para
// angulos rectos la rueda del lado de la punta avanza suave y
// la EXTERIOR retrocede — el carro se arquea hacia atras y
// remonta el vertice bajo el trio en vez de alejarse.
// Regla del usuario (v3.29): una rueda solo retrocede si su
// contraria adelanta — contra-rotacion: el carro gira sobre su
// eje hacia la punta sin irse hacia atras. Y solo en perdida
// completa del trio con info de una sola punta (caso extremo que
// el seguimiento no debe dejar llegar). Busqueda sin punta sigue
// siendo solo adelante.
const int VEL_ESQ_INT = -140; // v3.43: -70 quedaba bajo el umbral
                              // de stall — la rueda no giraba y el
                              // carro arqueaba hacia adelante en vez
                              // de rotar sobre su eje (doblaba tarde)
const int VEL_ESQ_EXT = 140;  // su contraria adelanta: contra-rotacion
                              // simetrica, giro sobre el eje
const unsigned long ESQ_MAX_MS = 900;   // v3.45: una horquilla de 180° no cabia en 400 ms — el pivote se cortaba a mitad de giro y caia en busqueda a ciegas. Sale antes si el trio reengancha; el techo solo cubre el peor caso.
                                        // trio en <300 ms; si no reengancha
                                        // la linea no estaba atras y
                                        // retroceder mas solo empeora
const unsigned long ESQ_ENFRIAR_MS = 800; // al expirar no se rearma: la
                                        // busqueda normal recupera como
                                        // siempre en las curvas suaves
const unsigned long ESQ_MIN_PUNTA_MS = 80; // la punta debe persistir:
                                          // un vertice real la sostiene;
                                          // en un vaiven solo flapea
const int ESQ_MIN_OSCUROS = 15;  // ~150 ms de trio oscuro: en un cruce
                                 // la rama prende una punta pero la linea
                                 // de adelante vuelve al trio rapido; en
                                 // un vertice pasado sigue oscuro
const int GRACIA_OSCUROS = 6;  // ~40 ms congelando la orden para que
                               // una punta declare la esquina

// Recuperacion de linea perdida (heredada de v2.12, probada)
const unsigned long GIRO_BUSQUEDA_MS = 450; // pivoteo antes de rebobinar
const int VEL_BUSQUEDA = 110; // 3.04: 130 pivotaba tan rapido que se
                              // pasaba la linea de largo al reenganchar.
                              // Si no gira (torque), anotar y subir a 115
const int VEL_REBOBINADO = 115;

// Cruce: S0 y S4 prendidos = camino perpendicular; avance recto
// comprometido para no tomar un ramal por una lectura a medias
const int VEL_CRUCE = 140;    // 3.02: acorde a la velocidad
const unsigned long AVANCE_CRUCE_MS = 140;
const int FRENO_CRUCE_MS = 150;   // parada en seco sobre la marca:
                              // no alejarse del cruce antes de
                              // decidir — el truco de las versiones
                              // que no perdian la referencia
const unsigned long CRUCE_ENFRIAR_MS = 800;
                              // no alejarse del cruce antes de
                              // decidir — el truco de las versiones
                              // que no perdian la referencia

// Boost de recta: |posF| bajo sostenido = recta de verdad
const float RECTA_POS = 0.35;
const int RECTA_CICLOS = 12;    // ~80 ms seguidos antes de subir
const float RECTA_SOLTAR = 0.8; // histeresis
const int BOOST_RECTA = 0;      // extra sobre VEL_MAX (0 = apagado;
                                // 3.01: la velocidad no es el objetivo)

// Trim de motores (1.0 = igual). Interpola entre TRIM_DER abajo
// y TRIM_DER_ALTA a 255: la deriva cambia con la velocidad.
const float TRIM_IZQ = 1.0;
const float TRIM_DER = 1.02;
const float TRIM_DER_ALTA = 0.85;

// Compuerta de arranque: margen en ADC crudo contra el blanco
const int MARGEN_PISTA = 300;

// Antirrebote del pulsador
const unsigned long BTN_DEBOUNCE_MS = 50;

// Calibracion inicial de laboratorio (por canal). En cinta negra
// sobre papel blanco: blanco ~26-30, negro ~850-960. La siembra
// viva de largada los reemplaza con el rango real de la pista.
int calMin[5] = {30, 30, 30, 30, 30};
int calMax[5] = {930, 930, 930, 930, 930};

const int CANALES[5] = {S0, S1, S2, S3, S4};

int lecturas[5];
bool neg[5];                    // estado binario por canal, con histeresis
bool s2Antes = true;            // para detectar el flanco de caida de S2
float posF = 0;
float posPrev = 0;
int ciclosOscuros = 0;          // ciclos seguidos con el trio a oscuras
byte maskOscuro = 0;            // quien veia linea en el 1er ciclo oscuro
unsigned long oscuroDesde = 0;
unsigned long esqDesde = 0;     // inicio de la maniobra de esquina (0 = no)
unsigned long puntaDesde = 0, parDesde = 0, posDesde = 0;   // desde cuando la punta lleva prendida
unsigned long esqEnfriar = 0;   // enfriamiento tras una maniobra E
unsigned long perdidaDesde = 0; // inicio de la recuperacion (0 = no)
unsigned long cruceHasta = 0;
unsigned long trioLlenoHasta = 0; // ventana de rama de cruce
unsigned long cruceEnfriar = 0;   // v3.41: no re-declarar sobre
                                  // la misma marca — el C quedaba
                                  // en parada-arranque continuo
int ultimoLado = 0;             // -1 izquierda, +1 derecha
int alertaLado = 0;             // lado de la alerta abierta (signo de posF)
float alertaPico = 0;           // mayor |posF| durante la alerta abierta
int ciclosRecta = 0;
bool boostActivo = false;
int velIzqCmd = 0;              // ultima orden: la gracia la congela
unsigned long ultMuestra = 0;   // ultimo evento 'm' emitido
int muestraN = 0;               // contador: cada 5 'm' emite 'i'
float integ = 0;                // integral de posF (auto-trim)
int velDerCmd = 0;
bool arrancado = false;
bool btnPrev = HIGH;
bool preparado = false;
unsigned long btnUltimo = 0;
unsigned long inicioCarrera = 0;

// Metricas de la corrida: se guardan en EEPROM y se leen con 'r'
unsigned int perdidas = 0;      // entradas a recuperacion (trio oscuro sin punta)
unsigned int cruces = 0;        // S0 y S4 prendidos a la vez
unsigned int esquinas = 0;      // maniobras de esquina
unsigned int s2perdidas = 0;    // flancos de caida de S2 (la metrica a bajar)
unsigned int alertas = 0;       // alertas abiertas
unsigned int sobrepasos = 0;    // alertas que cruzaron al lado contrario
unsigned int resueltas = 0;     // alertas cerradas volviendo al centro

// Mapa de EEPROM (se conserva solo la ultima corrida)
const byte EE_FIRMA = 0xA3;         // formato v3 (0xA2 era la linea 2.x)
const int EE_FIRMA_DIR = 0;         // 1 byte
const int EE_NEV = 1;               // 1 byte: cantidad de eventos
const int EE_TIEMPO = 2;            // 4 bytes: ms de carrera (0 = sin cierre)
const int EE_PERD = 6;              // 1 byte: perdidas
const int EE_CRUCES = 7;            // 1 byte: cruces
const int EE_CAL = 8;               // 20 bytes: calMin/calMax finales
const int EE_STATS = 28;            // 5 bytes: alertas, sobrepasos,
                                    // esquinas, s2perdidas, resueltas
const int EE_EVENTOS = 36;          // 4 bytes por evento:
                                    // tipo + decimas de s + info
const int EE_MAX_EV = 200;          // 36 + 200*4 = 836 < 1024

// --- MOTORES (velocidad con signo: + adelante, - atras) ---
void motorIzq(int vel) {
  vel = constrain(vel, -255, 255);
  if (vel >= 0) {
    analogWrite(IN1, vel);
    digitalWrite(IN2, LOW);
  } else {
    digitalWrite(IN1, LOW);
    analogWrite(IN2, -vel);
  }
}

void motorDer(int vel) {
  vel = constrain(vel, -255, 255);
  if (vel >= 0) {
    analogWrite(IN3, vel);
    digitalWrite(IN4, LOW);
  } else {
    digitalWrite(IN3, LOW);
    analogWrite(IN4, -vel);
  }
}

void detener() {
  motorIzq(0); motorDer(0);
}

// --- SENSORES Y CALIBRACION ADAPTATIVA ---
// Lee los 5 canales y expande calMin/calMax con cada extremo nuevo.
void leerSensores() {
  for (int i = 0; i < 5; i++) {
    int v = analogRead(CANALES[i]);
    lecturas[i] = v;
    if (v < calMin[i]) calMin[i] = v;
    if (v > calMax[i]) calMax[i] = v;
  }
}

// Negrura de un canal normalizada 0..1 segun su calibracion
float negrura(int i) {
  float n = (float)(lecturas[i] - calMin[i]) / (float)(calMax[i] - calMin[i]);
  if (n < 0) n = 0;
  if (n > 1) n = 1;
  return n;
}

// Estado binario por canal con histeresis: prende sobre NEG_ON,
// apaga bajo NEG_OFF, entre los dos conserva lo que tenia. Asi el
// estado no parpadea con el ruido del borde de la cinta.
void leerBinarios() {
  for (int i = 0; i < 5; i++) {
    float n = negrura(i);
    if (neg[i]) {
      if (n < NEG_OFF) neg[i] = false;
    } else if (n > NEG_ON) {
      neg[i] = true;
    }
  }
}

// Calibracion viva: corre en cada ciclo de la espera. El apoyo
// garantiza S0/S4 sobre blanco y S2 sobre negro, asi que el blanco
// real es el menor de las puntas y el negro real lo da S2. Si no
// hay contraste (en la mano, mal apoyado) no siembra.
void sembrarPista() {
  int blanco = min(lecturas[0], lecturas[4]);
  int negro = lecturas[2];
  if (negro - blanco < 50) return;
  for (int i = 0; i < 5; i++) {
    calMin[i] = blanco;
    calMax[i] = negro;
  }
}

// --- REGISTRO EN EEPROM ---
// Al largar: deja el registro en cero (solo escribe bytes que cambian).
void eeIniciar() {
  EEPROM.update(EE_FIRMA_DIR, EE_FIRMA);
  EEPROM.update(EE_NEV, 0);
  EEPROM.update(EE_PERD, 0);
  EEPROM.update(EE_CRUCES, 0);
  EEPROM.put(EE_TIEMPO, 0UL);
  for (int i = 0; i < 5; i++) EEPROM.update(EE_STATS + i, 0);
}

// Vuelca los contadores a EEPROM; se llama en cada evento y al
// cerrar, asi el informe sobrevive aunque se apague en carrera.
void eeStats() {
  EEPROM.update(EE_PERD, perdidas > 255 ? 255 : perdidas);
  EEPROM.update(EE_CRUCES, cruces > 255 ? 255 : cruces);
  EEPROM.update(EE_STATS + 0, alertas > 255 ? 255 : alertas);
  EEPROM.update(EE_STATS + 1, sobrepasos > 255 ? 255 : sobrepasos);
  EEPROM.update(EE_STATS + 2, esquinas > 255 ? 255 : esquinas);
  EEPROM.update(EE_STATS + 3, s2perdidas > 255 ? 255 : s2perdidas);
  EEPROM.update(EE_STATS + 4, resueltas > 255 ? 255 : resueltas);
}

// En carrera: agrega un evento con su tiempo y un byte de info.
// Tipos: 'a' alerta linea a la izq, 'd' alerta a la der (info =
// |posF|*100 de entrada), 'k' alerta resuelta al centro y 'o'
// sobrepaso al lado contrario (info = pico *100), 's' caida de S2
// (info = mascara de quien veia linea), 'E' esquina (info = mascara
// de puntas), 'R' reenganche (info = decimas de s a oscuras), 'P'
// perdida real (info = mascara de vista), 'C' cruce, 'B' boost.
void eeEvento(char tipo, byte info) {
  byte n = EEPROM.read(EE_NEV);
  if (n < EE_MAX_EV) {
    int dir = EE_EVENTOS + 4 * n;
    unsigned int d = (millis() - inicioCarrera) / 100;
    EEPROM.update(dir, (byte)tipo);
    EEPROM.put(dir + 1, d);
    EEPROM.update(dir + 3, info);
    EEPROM.update(EE_NEV, n + 1);
  }
  eeStats();
}

// Al detener: guarda calibracion final, contadores y tiempo total.
void eeCerrar() {
  unsigned long t = millis() - inicioCarrera;
  if (t == 0) t = 1;
  for (int i = 0; i < 5; i++) {
    EEPROM.put(EE_CAL + 4 * i, (unsigned int)calMin[i]);
    EEPROM.put(EE_CAL + 4 * i + 2, (unsigned int)calMax[i]);
  }
  eeStats();
  EEPROM.put(EE_TIEMPO, t);
}

void eeBorrar() {
  EEPROM.update(EE_FIRMA_DIR, 0);
  Serial.println(F("Registro borrado."));
}

// Decodifica la mascara de 5 bits como lista de sensores
void imprimeVista(byte info) {
  Serial.print(F("  vista:"));
  if (info == 0) Serial.print(F(" nada"));
  for (int s = 0; s < 5; s++) {
    if (info & (1 << s)) {
      Serial.print(F(" S")); Serial.print(s);
    }
  }
}

void eeInforme() {
  if (EEPROM.read(EE_FIRMA_DIR) != EE_FIRMA) {
    Serial.println(F("EEPROM sin datos."));
    return;
  }
  unsigned long t;
  EEPROM.get(EE_TIEMPO, t);
  Serial.println(F("--- ULTIMA CORRIDA (v3.53) ---"));
  if (t > 0) {
    Serial.print(F("Tiempo (s): "));
    Serial.println(t / 1000.0, 1);
  } else {
    Serial.println(F("Sin cierre: se apago sin pulsador. Ver ultimo evento."));
  }
  Serial.print(F("Perdidas: ")); Serial.println(EEPROM.read(EE_PERD));
  Serial.print(F("Cruces: ")); Serial.println(EEPROM.read(EE_CRUCES));
  Serial.print(F("Alertas: ")); Serial.println(EEPROM.read(EE_STATS + 0));
  Serial.print(F("  resueltas al centro: ")); Serial.println(EEPROM.read(EE_STATS + 4));
  Serial.print(F("  sobrepasos (correccion pasada): ")); Serial.println(EEPROM.read(EE_STATS + 1));
  Serial.print(F("Esquinas: ")); Serial.println(EEPROM.read(EE_STATS + 2));
  Serial.print(F("S2 perdio senal: ")); Serial.println(EEPROM.read(EE_STATS + 3));
  if (t > 0) {
    Serial.println(F("Calibracion final (min-max):"));
    for (int i = 0; i < 5; i++) {
      unsigned int a, b;
      EEPROM.get(EE_CAL + 4 * i, a);
      EEPROM.get(EE_CAL + 4 * i + 2, b);
      Serial.print(F("S")); Serial.print(i);
      Serial.print(F(": ")); Serial.print(a);
      Serial.print(F("-")); Serial.println(b);
    }
  }
  byte n = EEPROM.read(EE_NEV);
  Serial.println(F("Eventos en segundos:"));
  Serial.println(F("a/d alerta izq/der (info=|posF| entra), k resuelta"));
  Serial.println(F("y o sobrepaso (info=pico), s caida S2, E esquina,"));
  Serial.println(F("R reenganche, P perdida, C cruce, B boost,"));
  Serial.println(F("m muestra de posF cada 200 ms:"));
  for (byte i = 0; i < n; i++) {
    int dir = EE_EVENTOS + 4 * i;
    char tipo = (char)EEPROM.read(dir);
    unsigned int d;
    EEPROM.get(dir + 1, d);
    byte info = EEPROM.read(dir + 3);
    Serial.print(tipo); Serial.print(F(" "));
    Serial.print(d / 10.0, 1);
    switch (tipo) {
      case 'a': case 'd':
        Serial.print(F("  pos=")); Serial.print(info / 100.0, 2);
        break;
      case 'm':
        Serial.print(F("  pos=")); Serial.print(info / 63.75 - 2.0, 2);
        break;
      case 'i':
        Serial.print(F("  integ=")); Serial.print((info - 128) * 4);
        break;
      case 'k': case 'o':
        Serial.print(F("  pico=")); Serial.print(info / 100.0, 2);
        break;
      case 's': case 'P':
        imprimeVista(info);
        break;
      case 'E':
        Serial.print(F("  punta:"));
        if (info & 1) Serial.print(F(" S0"));
        if (info & 16) Serial.print(F(" S4"));
        break;
      case 'R':
        Serial.print(F("  oscuros=")); Serial.print(info / 10.0, 1);
        Serial.print(F("s"));
        break;
    }
    Serial.println();
  }
  Serial.println(F("--- FIN ---"));
}

void setup() {
  pinMode(IN1, OUTPUT);
  pinMode(IN2, OUTPUT);
  pinMode(IN3, OUTPUT);
  pinMode(IN4, OUTPUT);
  detener();

  // Despertar el DRV8833 (EEP en HIGH)
  pinMode(SLEEP_DRV, OUTPUT);
  digitalWrite(SLEEP_DRV, HIGH);
  pinMode(FAULT_PIN, INPUT_PULLUP);
  pinMode(BTN, INPUT_PULLUP); // presionado = LOW

  Serial.begin(9600);
  Serial.println(F("===== ARTURITO v3.53 ====="));
  Serial.println(F("Comandos: r o t = informe, b = borrar"));
}

void loop() {
  leerSensores();
  leerBinarios();

  // 1. Pulsador: flancos con antirrebote. Apretar prepara la
  //    largada, soltar la ejecuta; en carrera, apretar detiene.
  bool btn = digitalRead(BTN);
  bool flancoBajo = false, flancoAlto = false;
  if (btn != btnPrev && millis() - btnUltimo > BTN_DEBOUNCE_MS) {
    btnUltimo = millis();
    btnPrev = btn;
    if (btn == LOW) flancoBajo = true;
    else flancoAlto = true;
  }

  // 2. Compuerta de arranque: apretar arma y soltar larga, solo si
  //    el apoyo es bueno en ese instante: S2 sobre negro con margen
  //    contra el blanco que ven S0/S4, y las puntas libres.
  if (!arrancado) {
    if (flancoBajo) preparado = true;
    if (flancoAlto && preparado) {
      preparado = false;
      int blanco = min(lecturas[0], lecturas[4]);
      bool apoyoOk = lecturas[2] - blanco > MARGEN_PISTA &&
                     lecturas[0] - blanco < MARGEN_PISTA / 2 &&
                     lecturas[4] - blanco < MARGEN_PISTA / 2;
      if (apoyoOk) {
        arrancado = true;
        posF = posPrev = 0;
        ciclosOscuros = 0;
        oscuroDesde = 0;
        esqDesde = 0;
        perdidaDesde = 0;
        cruceHasta = 0;
        ultimoLado = 0;
        alertaLado = 0;
        alertaPico = 0;
        ciclosRecta = 0;
        boostActivo = false;
        velIzqCmd = velDerCmd = 0;
        s2Antes = true;
        perdidas = cruces = esquinas = s2perdidas = 0;
        alertas = sobrepasos = resueltas = 0;
        eeIniciar();
        inicioCarrera = millis();
        ultMuestra = millis();
        integ = 0;
        Serial.print(F("Pista: blanco ")); Serial.print(blanco);
        Serial.print(F(" negro ")); Serial.println(lecturas[2]);
      }
    }
    if (!arrancado) {
      detener();
      sembrarPista(); // siembra en vivo mientras espera la largada
      if (Serial.available()) {
        char c = Serial.read();
        if (c == 'r' || c == 't') eeInforme();
        else if (c == 'b') eeBorrar();
      }
      delay(2);
      return;
    }
  }
  // 3. En carrera: apretar detiene y devuelve a la espera. El mismo
  //    apretado no arma (preparado queda en falso), asi que soltar
  //    no relanza.
  else if (flancoBajo) {
    arrancado = false;
    detener();
    eeCerrar();
    delay(2);
    return;
  }

  // 4. Caida de S2: la metrica central de la 3.x. Cada flanco deja
  //    evento 's' con la mascara de quien seguia viendo linea.
  if (s2Antes && !neg[2]) {
    s2perdidas++;
    byte vista = 0;
    for (int i = 0; i < 5; i++) {
      if (negrura(i) > 0.15) vista |= (1 << i);
    }
    eeEvento('s', vista);
  }
  s2Antes = neg[2];

  // 5. Cruce comprometido: recto sin leer hasta que venza el tramo
  if (cruceHasta) {
    if (millis() < cruceHasta) {
      motorIzq(VEL_CRUCE); motorDer(VEL_CRUCE);
      delay(2);
      return;
    }
    cruceHasta = 0;
  }

  // Lecturas continuas de este ciclo
  float n0 = negrura(0), n1 = negrura(1), n2 = negrura(2);
  float n3 = negrura(3), n4 = negrura(4);
  float trio = n1 + n2 + n3;
  float suma = trio + K_PUNTA * (n0 + n4);

  // 6. Cruce de caminos: las dos puntas prendidas a la vez solo lo
  //    da un camino perpendicular bajo el arreglo. Recto fijo.
  //    v3.53: exige el trio vivo — en el vertice las dos puntas
  //    prenden con el trio muerto y la firma comia la esquina.
  if (neg[0] && neg[4] && trio > TRIO_MIN
      && millis() - cruceEnfriar > CRUCE_ENFRIAR_MS) {
    cruceHasta = millis() + AVANCE_CRUCE_MS;
    posF = posPrev = 0;
    perdidaDesde = 0;
    esqDesde = 0;
    ciclosOscuros = 0;
    alertaLado = 0;
    cruces++;
    cruceEnfriar = millis();
    motorIzq(0); motorDer(0); delay(FRENO_CRUCE_MS);   // v3.38
    motorIzq(VEL_CRUCE); motorDer(VEL_CRUCE);
    velIzqCmd = velDerCmd = VEL_CRUCE;
    eeEvento('C', 0);
    delay(2);
    return;
  }

  // v3.44: la firma C por pareja lateral + S2 (v3.39) se comia
  // las esquinas reales — la misma geometria la da el vertice.
  // Se elimina: esa geometria ahora va al camino de esquina.

  // Ventana de rama: el travesano del cruce prende el trio
  // completo; unos ciclos despues una punta sola es la otra
  // rama — no una esquina. (v3.37)
  if (neg[1] && neg[2] && neg[3]) trioLlenoHasta = millis() + 400;

  bool enManiobra = (esqDesde != 0 || perdidaDesde != 0);
  bool trioOk = trio > (enManiobra ? TRIO_ENGANCHE : TRIO_MIN);

  // 7. Trio con linea a la vista: el regimen normal. Correccion
  //    proporcional acelerando la rueda del lado que perdio.
  if (trioOk) {
    // Reenganche tras esquina o perdida: cuanto duro a oscuras
    if (enManiobra && oscuroDesde) {
      eeEvento('R', (byte)min(255L, (millis() - oscuroDesde) / 100));
    }
    esqDesde = 0;
    perdidaDesde = 0;
    ciclosOscuros = 0;
    oscuroDesde = 0;

    // Posicion lateral ponderada (-2 izq .. +2 der): el trio pesa
    // 1 por canal, las puntas K_PUNTA — avisan antes, no mandan.
    // Con mas de una linea bajo el arreglo el centroide miente:
    // posF se congela en lo que traia.
    if (suma < SUMA_AMBIGUA) {
      float pos = (-2.0 * K_PUNTA * n0 - n1 + n3 + 2.0 * K_PUNTA * n4) / suma;
      // Zona ciega: con la linea de 20 mm centrada solo S2 la ve y
      // pos queda ~0 hasta ~5 mm de desvio. El deficit de n2 (S2
      // perdiendo negro) avisa antes que pos se mueva: amplificar
      // pos por (1 - n2) hace visible la deriva de 2-3 mm.
      pos *= (1.0 + GAN_BORDE * (1.0 - n2));
      posF += ALPHA * (pos - posF);        // EMA: corta los saltos
      if (posF > 0.2) ultimoLado = 1;
      else if (posF < -0.2) ultimoLado = -1;
    }
    // Derivada del ciclo (posF ya viene filtrada). Tras un tramo
    // oscuro posPrev trae el valor viejo: deriv sale en 0 al
    // reenganchar — mismo arreglo que la corrida #20 de la 2.x.
    float deriv = posF - posPrev;
    posPrev = posF;

    // Registro de alertas: abre al pasar ALERTA_POS, cierra al
    // volver bajo ALERTA_OK ('k') o al cruzar al lado contrario
    // ('o' = la correccion se paso: el dato para ajustar K_CORR).
    if (alertaLado == 0) {
      if (posF > ALERTA_POS || posF < -ALERTA_POS) {
        alertaLado = (posF > 0) ? 1 : -1;
        alertaPico = (posF > 0) ? posF : -posF;
        alertas++;
        eeEvento(posF > 0 ? 'd' : 'a', (byte)min(255.0, (posF > 0 ? posF : -posF) * 100));
      }
    } else {
      float ap = (posF > 0) ? posF : -posF;
      if (ap > alertaPico) alertaPico = ap;
      if (posF * alertaLado < -ALERTA_POS) {
        sobrepasos++;
        eeEvento('o', (byte)min(255.0, alertaPico * 100));
        alertaLado = (posF > 0) ? 1 : -1;
        alertaPico = ap;
        alertas++;
        eeEvento(posF > 0 ? 'd' : 'a', (byte)min(255.0, ap * 100));
      } else if (ap < ALERTA_OK) {
        resueltas++;
        eeEvento('k', (byte)min(255.0, alertaPico * 100));
        alertaLado = 0;
      }
    }

    // pos saturado sostenido con el trio aun viendo (v3.49):
    // la correccion proporcional no alcanzo para el giro — es
    // vertice aunque la linea siga bajo S1/S3. Giro sobre el
    // eje hacia el lado del signo.
    {
      float apS = posF > 0 ? posF : -posF;
      if (apS > 0.95) {
        // v3.50: solo si no esta volviendo — si posF mejora
        // (deriv hacia el centro), el lazo trabaja y el pivote
        // seria un robo de maniobra.
        if (posF * deriv < 0) posDesde = millis();   // volviendo: rearma la ventana
        else if (!posDesde) posDesde = millis();
        if (posDesde && millis() - posDesde >= 300 && esqDesde == 0) {
          ultimoLado = posF < 0 ? -1 : 1;
          esqDesde = millis();
          esquinas++;
          eeEvento('E', 0);
          posDesde = 0;
        }
      } else posDesde = 0;
      if (esqDesde != 0 && millis() - esqDesde < ESQ_MAX_MS) {
        float fuerza = (neg[1] || neg[3]) ? 0.5 : 1.0;
        int esqInt = VEL_ESQ_INT;
        int esqExt = (int)(VEL_ESQ_EXT * fuerza);
        motorIzq(ultimoLado < 0 ? esqInt : esqExt);
        motorDer(ultimoLado < 0 ? esqExt : esqInt);
        velIzqCmd = (ultimoLado < 0) ? esqInt : esqExt;
        velDerCmd = (ultimoLado < 0) ? esqExt : esqInt;
        delay(2);
        return;
      }
    }
    // Boost con histeresis: arma con recta sostenida, suelta en curva
    if (boostActivo) {
      if (posF > RECTA_SOLTAR || posF < -RECTA_SOLTAR) {
        boostActivo = false;
        ciclosRecta = 0;
      }
    } else {
      if (posF < RECTA_POS && posF > -RECTA_POS) ciclosRecta++;
      else ciclosRecta = 0;
      if (ciclosRecta >= RECTA_CICLOS) {
        boostActivo = true;
        if (BOOST_RECTA > 0) eeEvento('B', 0);
      }
    }

    int velMax = VEL_MAX + (boostActivo ? BOOST_RECTA : 0);
    // Arranque suave: el transitorio de largada es donde se pierde
    // siempre (s/P en los primeros 300 ms de todas las corridas).
    // velMax rampa de SUAVE_FRAC a 1 en SUAVE_MS — el abanico
    // inicial se juega a menor energia.
    {
      unsigned long msRun = millis() - inicioCarrera;
      if (msRun < SUAVE_MS) {
        velMax = (int)(velMax * (SUAVE_FRAC +
                 (1.0 - SUAVE_FRAC) * msRun / (float)SUAVE_MS));
      }
    }

    // Muestreo periodico de posF (evento 'm', cada MUESTRA_MS):
    // info = (posF + 2) * 63.75, se decodifica restando 2
    if (millis() - ultMuestra >= MUESTRA_MS) {
      ultMuestra = millis();
      eeEvento('m', (byte)constrain((int)((posF + 2.0) * 63.75), 0, 255));
      // Cada 5 muestras (~1 s) la integral: info = integ/4 + 128,
      // se decodifica restando 128 y multiplicando por 4
      if (++muestraN >= 5) {
        muestraN = 0;
        eeEvento('i', (byte)constrain((int)(integ / 4 + 128), 0, 255));
      }
    }

    // Correccion = PD + I: la integral acumula el sesgo sostenido
    // de posF y corrige el equilibrio (pos ~+0.25 en v3.18) — el
    // carrito calibra su propio centro. Anti-windup: decae en
    // excursion (|posF|>0.9) y topa en INTEG_MAX.
    float ap = posF > 0 ? posF : -posF;
    {
      // Acumula solo en zona util (|posF|<0.7); en excursion se
      // congela — el decaimiento de v3.19 la evaporaba en ~100 ms
      // y nunca llego a actuar (traza de v3.20: integ 0->8)
      if (ap < 1.0) integ += posF;
      if (integ > INTEG_MAX) integ = INTEG_MAX;
      else if (integ < -INTEG_MAX) integ = -INTEG_MAX;
    }
    // Zona de recta (v3.35): micro-correccion continua — la
    // ganancia efectiva crece de KP_ZONA a KP segun la desviacion,
    // sin salto en el borde. El zigzag de tramos rectos era el
    // bang-bang: nada dentro de la zona, correccion grande afuera.
    float kpEff = KP_ZONA + (KP - KP_ZONA)
                * (ap < ZONA_RECTA ? ap / ZONA_RECTA : 1.0);
    float corr = kpEff * posF + KD * deriv + KI * integ;
    if (corr > CORR_MAX) corr = CORR_MAX;
    else if (corr < -CORR_MAX) corr = -CORR_MAX;
    // Dentro de la zona la base no cae: ruedas iguales a velMax
    int base = ap < ZONA_RECTA ? velMax
             : (int)(velMax - KS * ap
                     - KS2 * (deriv > 0 ? deriv : -deriv));
    if (base < VEL_MIN) base = VEL_MIN;
    int velIzq = (int)(base + corr);
    int velDer = (int)(base - corr);
    if (velIzq > 255) { velDer -= (velIzq - 255); velIzq = 255; }
    if (velDer > 255) { velIzq -= (velDer - 255); velDer = 255; }

    float trimDer = TRIM_DER + (TRIM_DER_ALTA - TRIM_DER) * (velMax / 255.0);
    velIzqCmd = constrain((int)(velIzq * TRIM_IZQ), VEL_PISO_INT, 255);
    velDerCmd = constrain((int)(velDer * trimDer), VEL_PISO_INT, 255);
    motorIzq(velIzqCmd);
    motorDer(velDerCmd);
    delay(2);
    return;
  }

  // 8. Trio a oscuras. Primer ciclo: foto de quien la veia todavia
  //    y cierre silencioso de la alerta abierta (el desenlace lo
  //    cuentan 'E' o 'P', no 'k' ni 'o').
  if (ciclosOscuros == 0) {
    maskOscuro = 0;
    for (int i = 0; i < 5; i++) {
      if (negrura(i) > 0.15) maskOscuro |= (1 << i);
    }
    oscuroDesde = millis();
    alertaLado = 0;
  }
  ciclosOscuros++;

  // Una sola punta viendo linea = vertice de esquina ya pasado:
  // la punta dice a que lado doblar. El pivote arranca con la
  // punta prendida y se sostiene aunque se apague a mitad del
  // giro (la linea barre hacia el trio: es lo esperado), hasta
  // que el trio reenganche o venza el techo.
  int ladoExt = 0;
  if (neg[0] && !neg[4]) ladoExt = -1;
  else if (neg[4] && !neg[0]) ladoExt = 1;
  if (ladoExt != 0) ultimoLado = ladoExt;
  // Rama de cruce (v3.37): punta sola dentro de la ventana del
  // trio lleno = camino perpendicular, seguir derecho.
  if (ladoExt != 0 && millis() < trioLlenoHasta && millis() - cruceEnfriar > CRUCE_ENFRIAR_MS) {
    trioLlenoHasta = 0;
    cruceHasta = millis() + AVANCE_CRUCE_MS;
    ciclosOscuros = 0;
    cruces++;
    cruceEnfriar = millis();
    eeEvento('C', 0);
    motorIzq(0); motorDer(0); delay(FRENO_CRUCE_MS);   // v3.38
    motorIzq(VEL_CRUCE); motorDer(VEL_CRUCE);
    velIzqCmd = velDerCmd = VEL_CRUCE;
    delay(2);
    return;
  }
  // La esquina se arma solo si la punta persiste prendida el
  // dwell: un vertice real la sostiene mientras el carro la pasa;
  // en un vaiven el trio parpadea y la punta solo roza — v3.24
  // pivotaba 4 veces en 2.7 s por flaps que no eran esquinas.
  if (ladoExt == 0) puntaDesde = 0;
  else if (puntaDesde == 0) puntaDesde = millis();
  // v3.40/42: la punta sola con el trio oscuro es el vertice —
  // parada en seco y giro sobre el eje, sin dwell ni espera.
  // v3.42 agrega la firma temprana: la pareja lateral con el
  // trio debil es la barra llegando — frena ahi, no cuando la
  // punta ya esta sola y el centro paso el vertice.
  // Pareja lateral persistente (v3.46): S0+S1 o S3+S4 juntos
  // >=40 ms es el vertice llegando — el trio puede seguir medio
  // prendido, como en la esquina izquierda que quedo sin girar.
  bool parIzq = neg[0] && neg[1], parDer = neg[3] && neg[4];
  if (parIzq || parDer) { if (!parDesde) parDesde = millis(); }
  else parDesde = 0;
  // pos saturado (v3.47): |posF|>0.9 sostenido es la linea
  // corriendose entera a un lado — vertice aunque ninguna punta
  // lo vea (la esquina que llego solo bajo S1).
  float apV = posF > 0 ? posF : -posF;
  if (apV > 0.9) { if (!posDesde) posDesde = millis(); }
  else posDesde = 0;
  // v3.51: la punta sola sostenida >=30 ms basta — el vertice
  // llega con el trio medio prendido y la puerta de oscuridad
  // nunca contaba (la esquina abierta que quedo sin pivote).
  bool vertice = (ladoExt != 0 && puntaDesde != 0
                  && millis() - puntaDesde >= 30)
              || (parDesde != 0 && millis() - parDesde >= 40)
              || (posDesde != 0 && millis() - posDesde >= 80);
  if (vertice && ladoExt == 0)
    ultimoLado = parDer ? 1 : parIzq ? -1 : (posF < 0 ? -1 : 1);
  if (vertice && esqDesde == 0
      && millis() - esqEnfriar > ESQ_ENFRIAR_MS) {
    motorIzq(0); motorDer(0); delay(FRENO_CRUCE_MS);
    esqDesde = millis();
    esquinas++;
    byte info = (neg[0] ? 1 : 0) | (neg[4] ? 16 : 0);
    eeEvento('E', info);
  }
  if (esqDesde != 0 && millis() - esqDesde < ESQ_MAX_MS) {
    // Autoregulacion del pivote (v3.24): la fuerza del arqueado
    // decae segun la linea re-entra al arreglo — solo punta =
    // arqueada completa; un medio tambien prendido = la linea ya
    // llega al trio y girar con todo la pasaria de largo, asi que
    // baja a la mitad; con S2 prendido sale el trioOk y vuelve el
    // seguimiento. El lado lo fija la punta que declaro.
    float fuerza = (neg[1] || neg[3]) ? 0.5 : 1.0;
    // v3.48: la interna siempre a pleno — cualquier escala la
    // deja bajo el stall (~135) y la rueda muere: el carro
    // arquea en vez de rotar. El decaimiento solo actua sobre
    // la rueda que adelanta.
    int esqInt = VEL_ESQ_INT;
    int esqExt = (int)(VEL_ESQ_EXT * fuerza);
    motorIzq(ultimoLado < 0 ? esqInt : esqExt);
    motorDer(ultimoLado < 0 ? esqExt : esqInt);
    velIzqCmd = (ultimoLado < 0) ? esqInt : esqExt;
    velDerCmd = (ultimoLado < 0) ? esqExt : esqInt;
    delay(2);
    return;
  }
  if (esqDesde != 0) esqEnfriar = millis();
  esqDesde = 0;

  // 9. Gracia: a oscuras y sin punta, congela la ultima orden unos
  //    ciclos — en una esquina la linea tarda un tramo en llegar a
  //    la punta, y declararla perdida antes de tiempo pivotaba al
  //    lado equivocado.
  if (ciclosOscuros <= GRACIA_OSCUROS) {
    motorIzq(velIzqCmd);
    motorDer(velDerCmd);
    delay(2);
    return;
  }

  // 10. Perdida real: pivotea hacia el ultimo lado que vio linea
  //     con una rueda adelante — sin rebobinado: nada retrocede.
  if (perdidaDesde == 0) {
    perdidaDesde = millis();
    perdidas++;
    eeEvento('P', maskOscuro);
  }
  // Cero reversa (v3.28): pivotea con una sola rueda adelante
  // hacia el ultimo lado que vio linea y barre hasta encontrarla.
  if (ultimoLado >= 0) { motorIzq(VEL_BUSQUEDA); motorDer(0); }
  else               { motorIzq(0); motorDer(VEL_BUSQUEDA); }
  delay(2);
}
