asosab/bot_sigue_linea/(commit log)

2026-11-03 Video de la vuelta completa: fondo lavado en la portada y embeds
    El clip de Arturito cerrando el circuito de práctica va en tres
    lugares: de fondo lavado en el hero del inicio (mp4 comprimido a
    1.2 MB, sin audio, apagado con prefers-reduced-motion), y como embed
    de youtube-nocookie con carga diferida en la galería del proyecto y
    en la entrada de cierre del diario. Nueva variante .yt.vertical para
    video de teléfono (9:16, angosto y centrado, sin bandas laterales).
    Generated with [Devin](https://devin.ai)
2026-11-03 humanamente: rompe la tríada de tríadas «de verdad» y un eco en metodo
    El párrafo «mecánica/electrónica/programación de verdad» forzaba tres
    ramas idénticas con tres ejemplos entre rayas cada una (P10) y además
    aparecía casi literal en index y en el cierre del diario. Se reescribe
    con un marco distinto por rama y sin el andamio de rayas, conservando
    cada detalle concreto. En metodo, la segunda tríada «qué se probó, qué
    falló, qué quedó decidido» cedía al mismo molde a dos párrafos de la
    primera.
    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
2026-11-03 Contador de espera en la sección de la carta
    La nota a la DDE salió el 3 de noviembre a las 9:55 y no tiene
    respuesta. Al pie de la sección #carta de concurso.html, un contador
    muestra años, días y horas transcurridos («La nota lleva X sin
    respuesta»). Anclado al envío de las 9:55 a la Departamental, en
    UTC-4, con los años calculados por aniversario real. Si no hay JS,
    el párrafo queda oculto.
    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
2026-11-03 Contador: solo campos con valor, en orden horas, días, años
    Ahora que la nota lleva pocas horas, mostrar «0 años, 0 días y 3
    horas» sobraba. Se listan solo las unidades mayores a cero, de menor
    a mayor («3 horas», «5 horas y 2 días», «7 horas, 3 días y 1 año»),
    y «menos de una hora» durante la primera hora.
    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
